CyberPit/FreeDSP_Classic_SMD_AB_plus-II/README.md

# FreeDSP_Classic_SMD_AB_plus-II

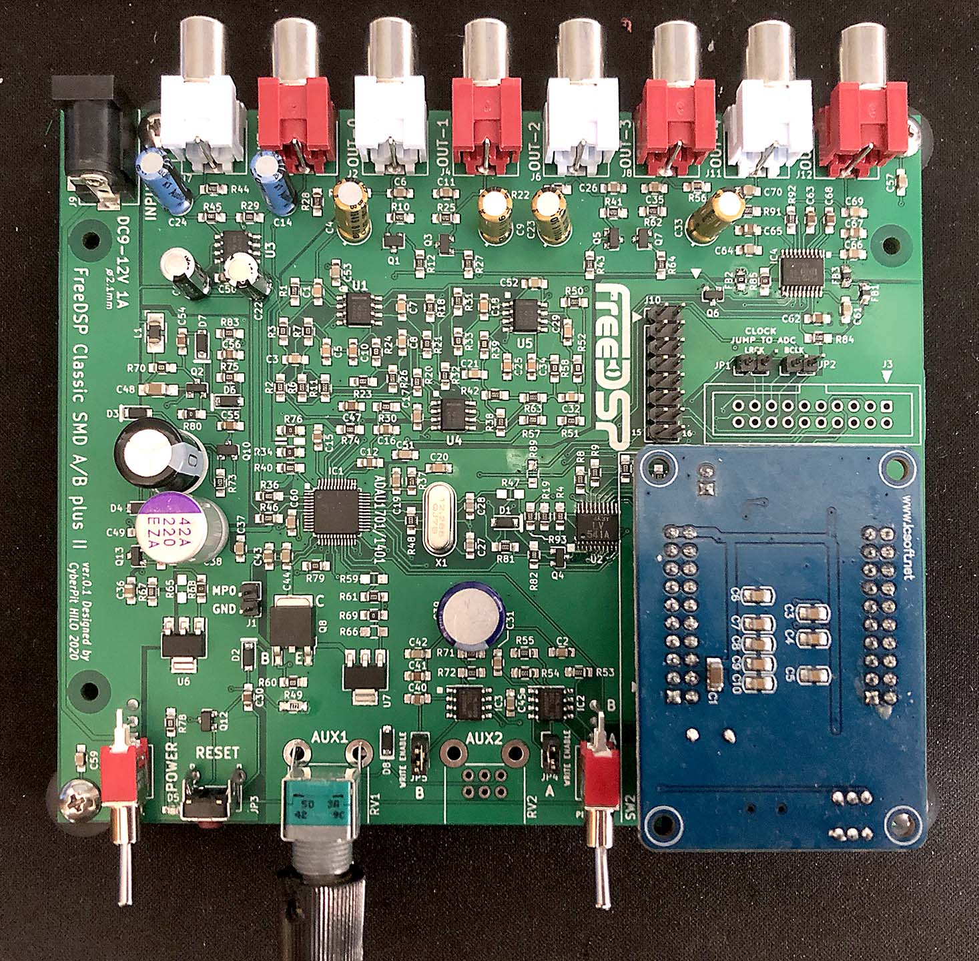
[picture p1: Photo/FDSPplus2Mounted.jpg]
Image of FreeDSP Classic SMD plus2


- 2in6out RCA jacks
- Integrated FreeUSBi
- A/B Selectable EEPROMs
- PCM5102A for DIG6/7
- ADAU1701 Board with selectable A/B Boot
- 0805(2.0mm x 1.25mm) SMD Resistors & Capacitors
- Through-Hole Ele-Caps
- Unity Gain Analog Audio I/O
- Absolute Phase transparent.
- Power ON/OFF/Reset Audio Pops Mute
- Buffered I2S I/O Headers (with Enable control feature)
- I6S Header pin for external DACs. 

Project web page: (Direct Link)
https://cyberpithilo.web.fc2.com/audio/freedsp/index.html

Project web page: (Yandex Machine Translation)
https://translate.yandex.com/translate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

Project web page: (Google Machine Translation)
https://translate.google.com/translate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

I had the ver0.1 board ordered to JLPCB (https://jlcpcb.com/) 
You can order SMT and Boards. My ordered PCBA file package is also included. 

# License
This work and all other materials under https://github.com/freeDSP are licensed under a Creative Commons Attribution Share-Alike 4.0 license. This allows for both personal and commercial derivative works, as long as they credit freeDSP and release their designs under the same license.
