CyberPit/FreeDSP_Classic_SMD_AB_plus-II/Photo/ChassisInsideTopiew.jpg

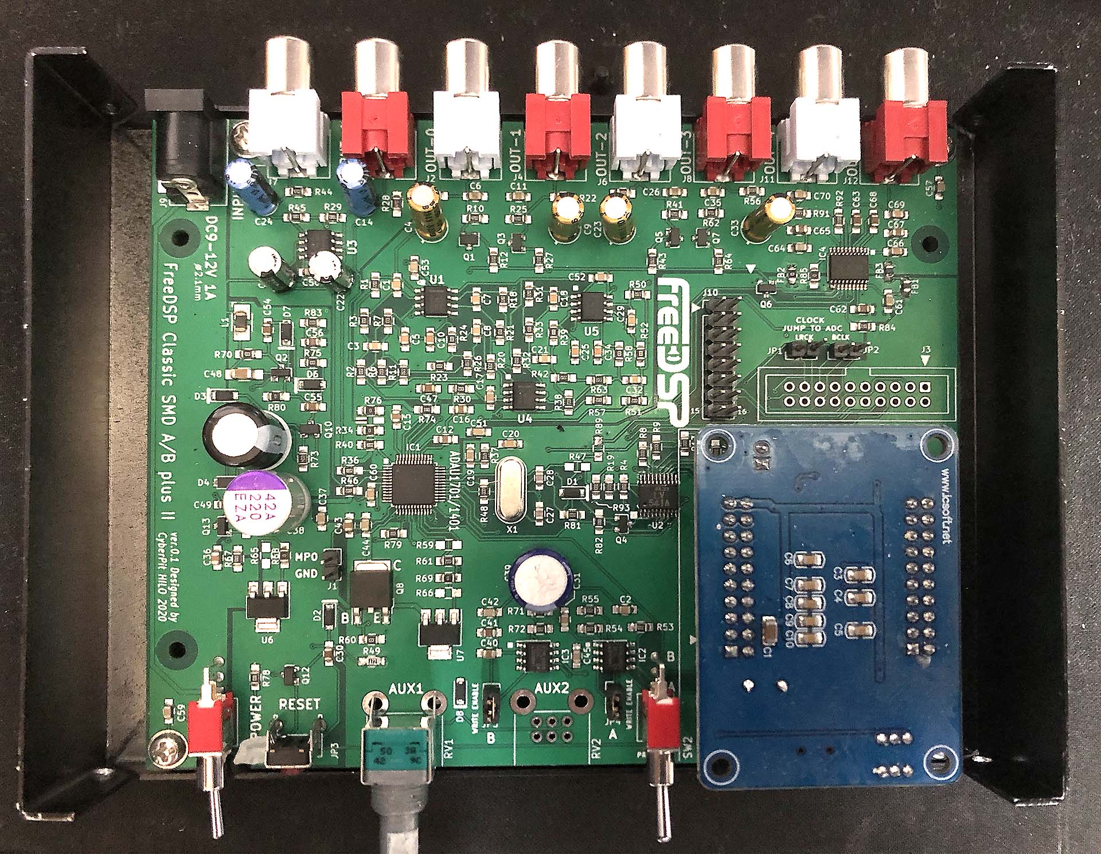
Photo/ChassisInsideTopiew.jpg
