CyberPit/FreeDSP_Classic_SMD_AB_plus-II/Photo/FreeDSP_SMD_AB_plus_TopView.jpg

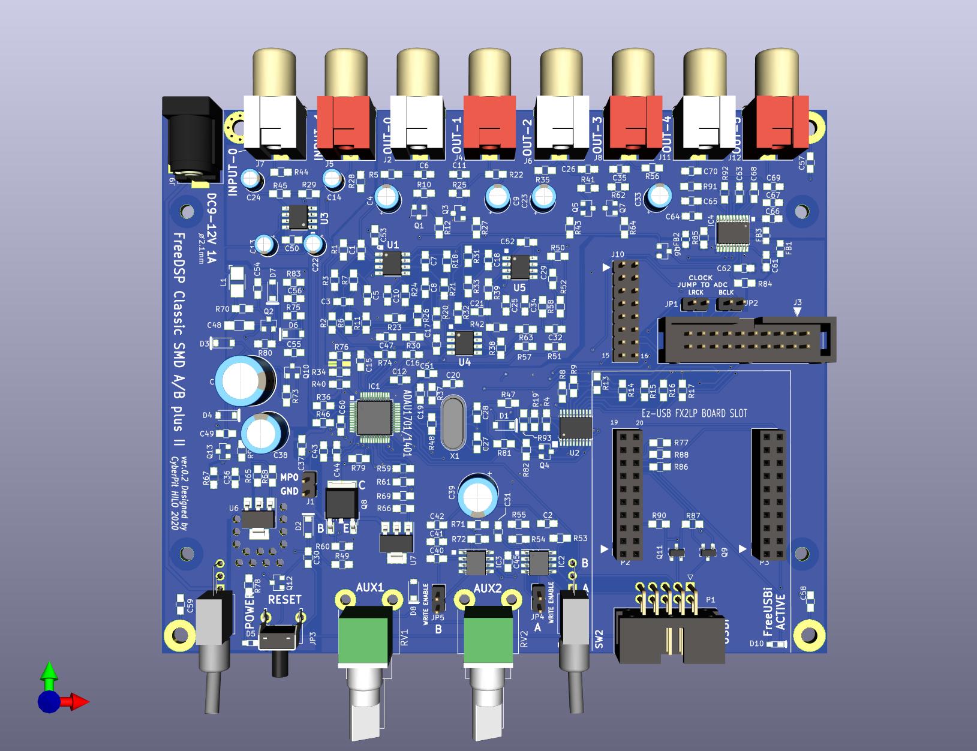
Photo/FreeDSP_SMD_AB_plus_TopView.jpg
