CyberPit/FreeDSP_Classic_SMD_AB_plus-II/Photo/FrontUp.jpg

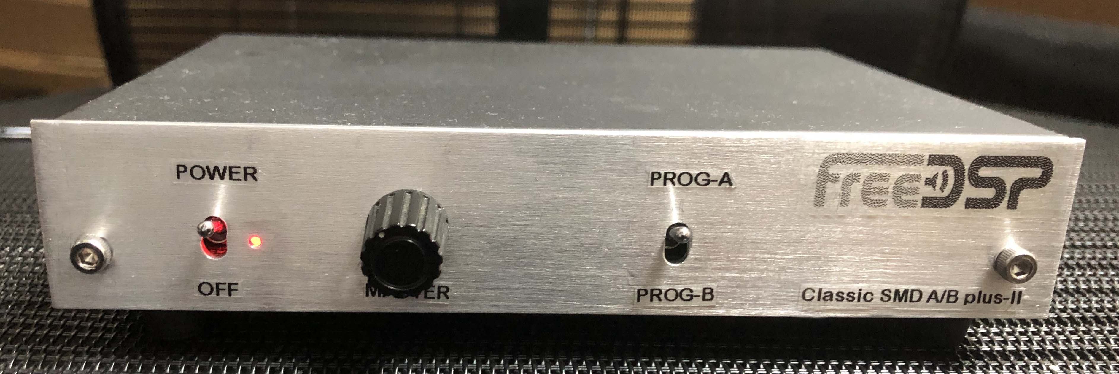
Photo/FrontUp.jpg
