CyberPit/FreeDSP_Classic_SMD_AB_plus-II/Photo/Measuring.jpg

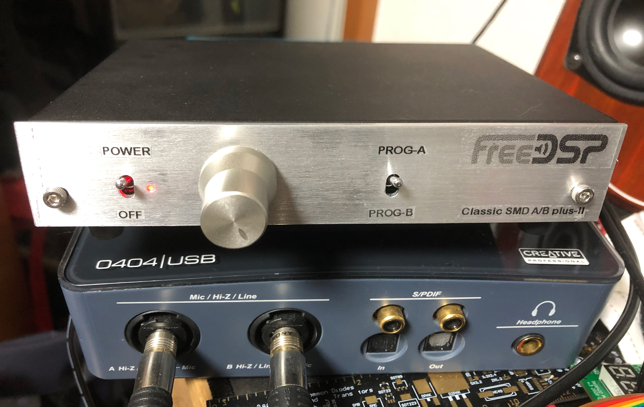
Photo/Measuring.jpg
