CyberPit/FreeDSP_Classic_SMD_AB_plus-II/Photo/NewFrontPanel.jpg

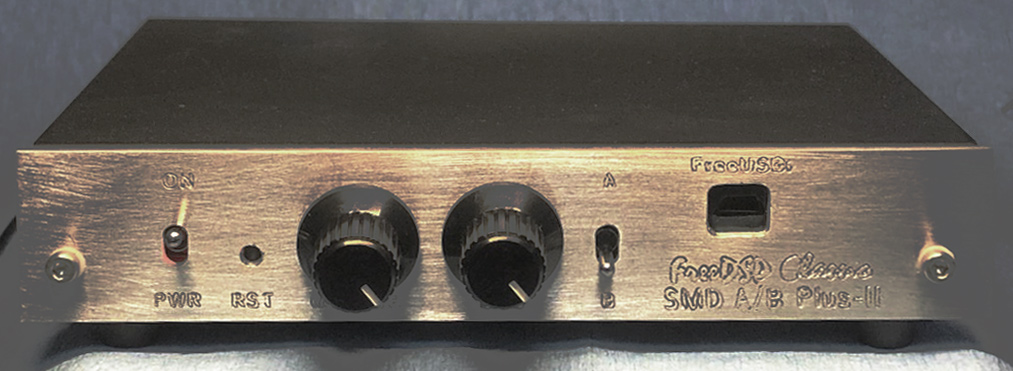
Photo/NewFrontPanel.jpg
