CyberPit/FreeDSP_Classic_SMD_AB_plus-II/Photo/PCBA@JLPCB.jpg

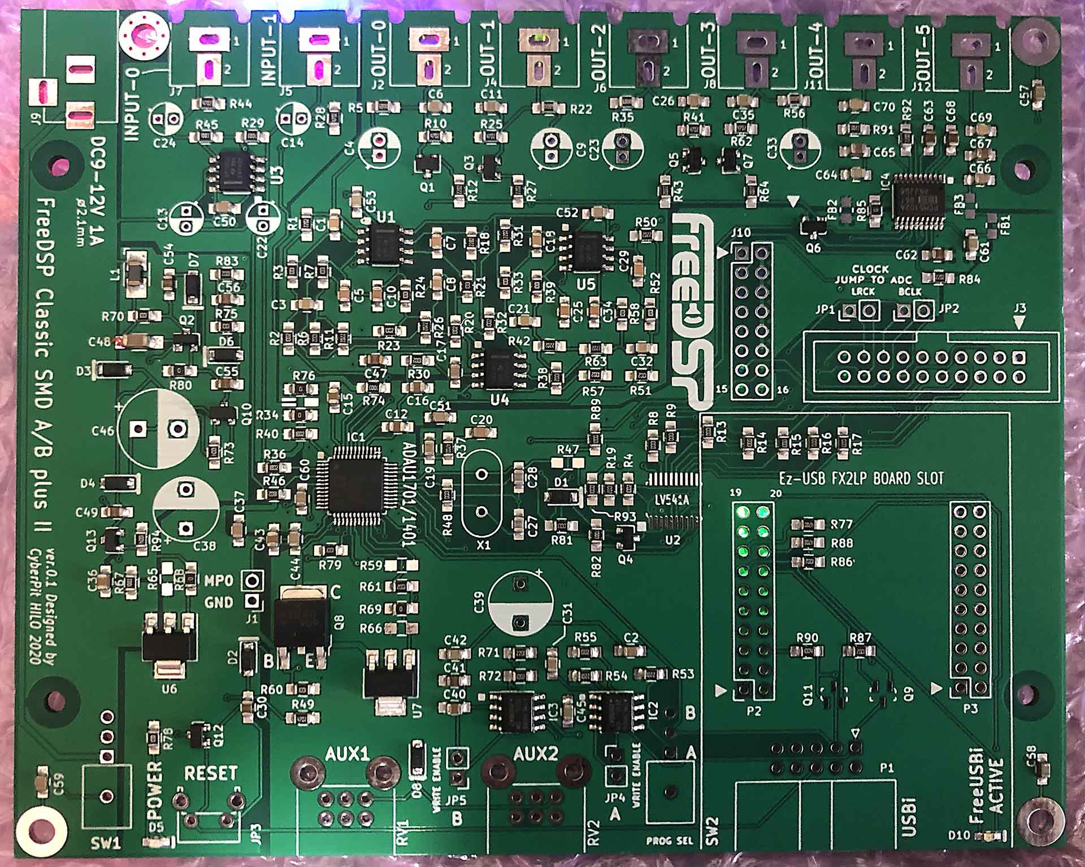
Photo/PCBA@JLPCB.jpg
