CyberPit/FreeDSP_Classic_SMD_AB_plus-II/Photo/PCBA_Bottom.jpg

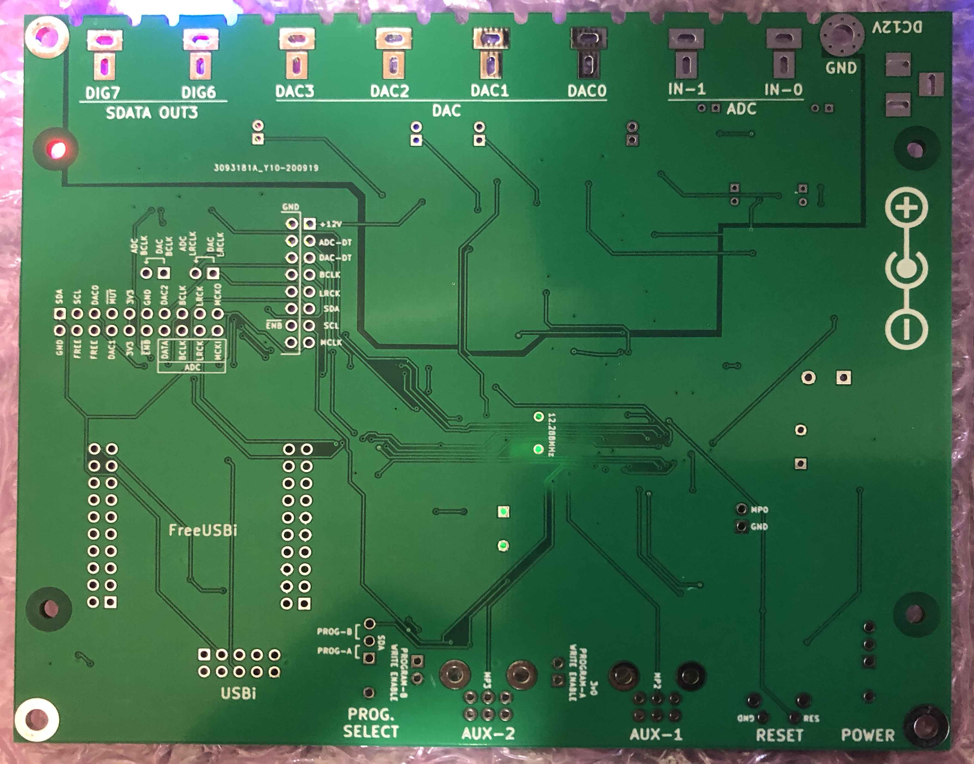
Photo/PCBA_Bottom.jpg
