CyberPit/FreeDSP_Classic_SMD_AB_plus-II/Photo/RerPanel.jpg

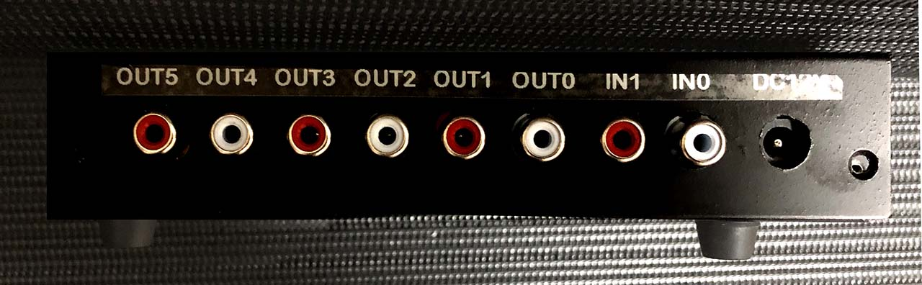
Photo/RerPanel.jpg
