CyberPit/FreeDSP_Classic_SMD_AB_plus-II/Photo/SigmaStudio96kHz_3way_CD_Example.GIF

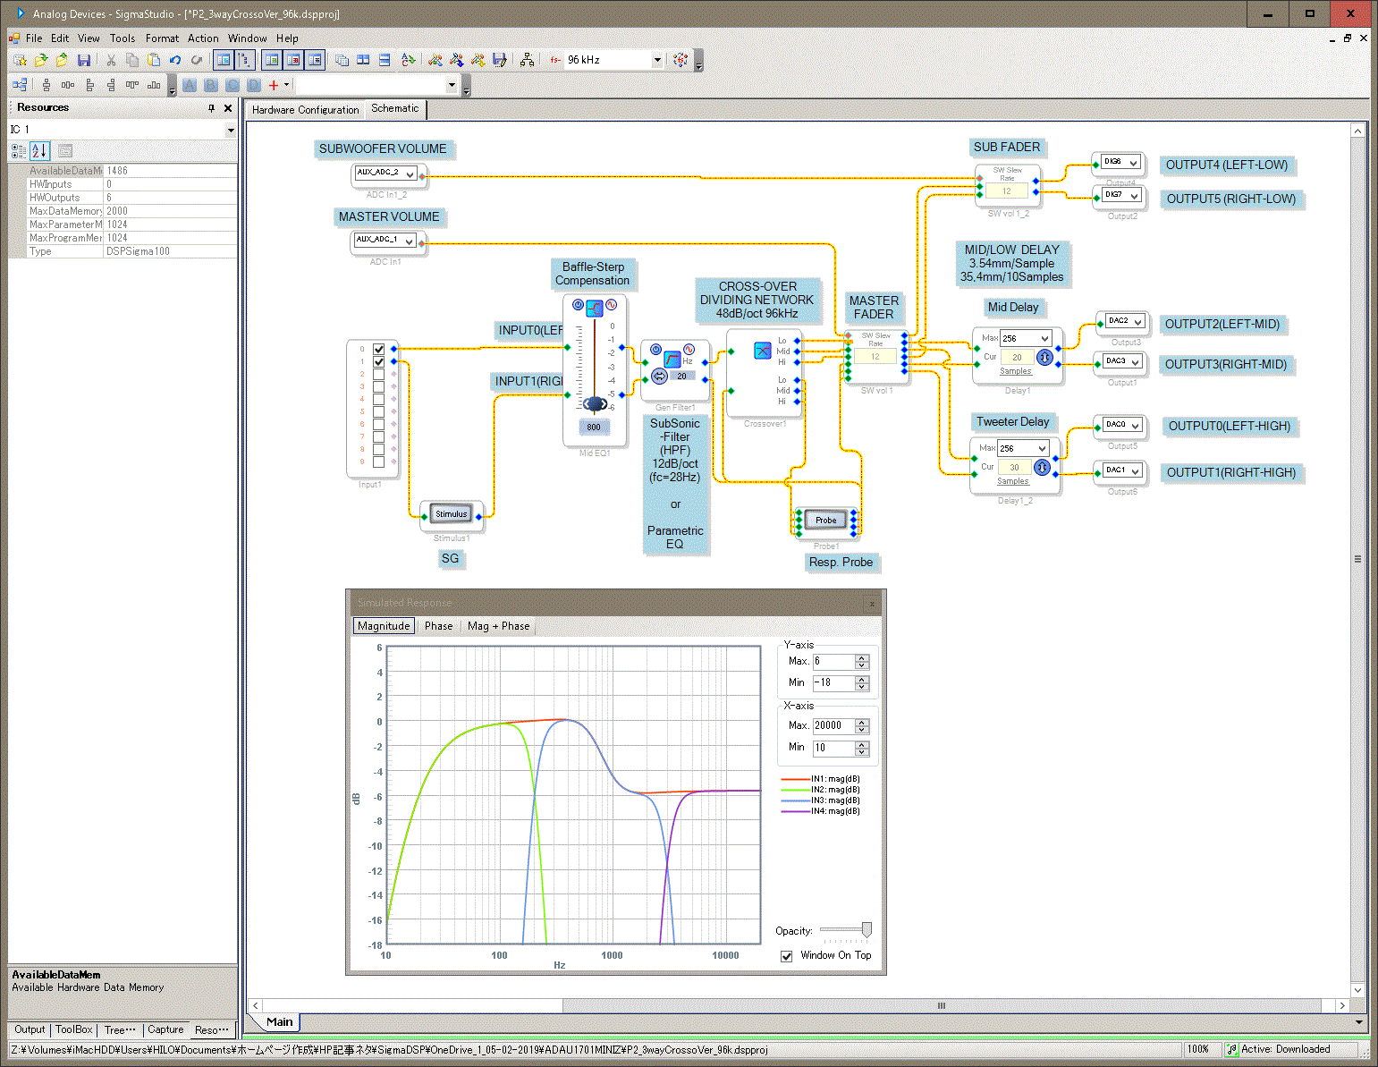
Photo/SigmaStudio96kHz_3way_CD_Example.GIF
