CyberPit/FreeDSP_Classic_SMD_AB_plus-II/Photo/SubPanel.jpg

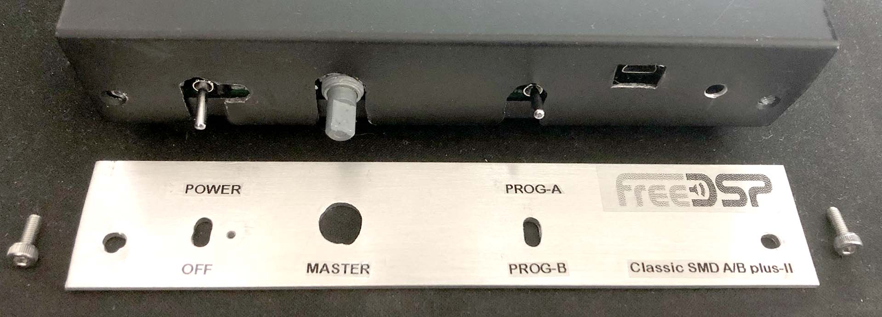
Photo/SubPanel.jpg
