CyberPit/FreeDSP_Classic_SMD_AB_plus-II/Photo/UpFront2.jpg

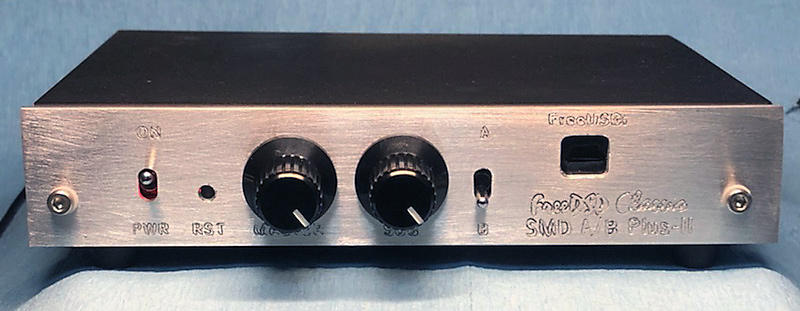
Photo/UpFront2.jpg
