CyberPit/FreeDSP_Classic_SMD_AB_plus-II/Photo/Working.jpg

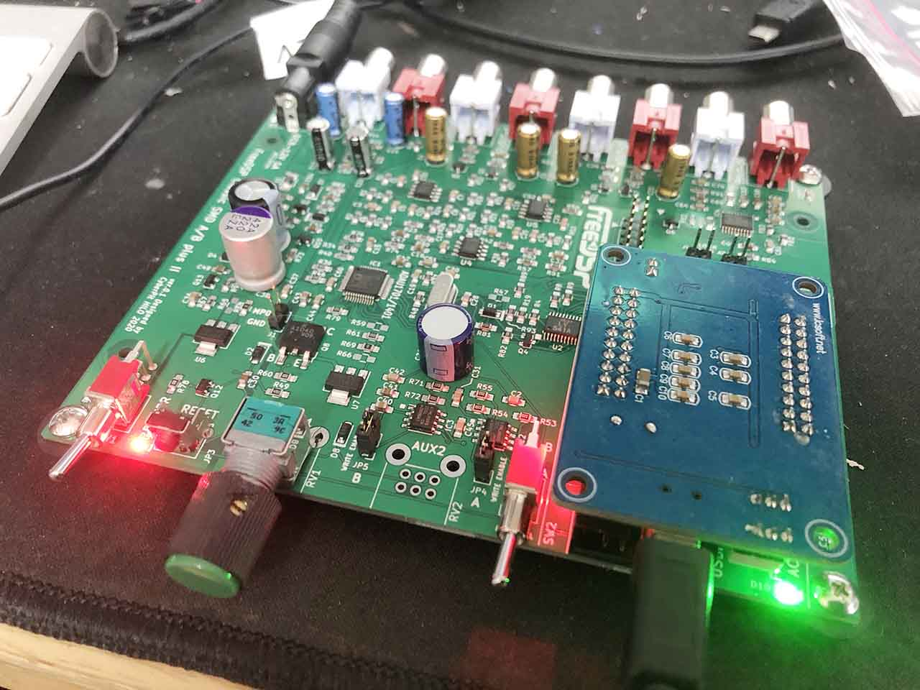
Photo/Working.jpg
