CyberPit/FreeDSP_Classic_SMD_AB_plus-II/RMAA HTML/Comparison/ct.png

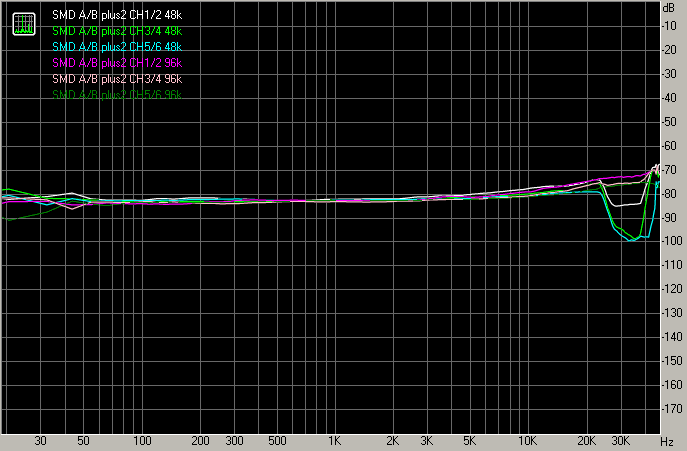
RMAA HTML/Comparison/ct.png
