CyberPit/FreeDSP_Classic_SMD_AB_plus-II/RMAA HTML/Comparison/dr.png

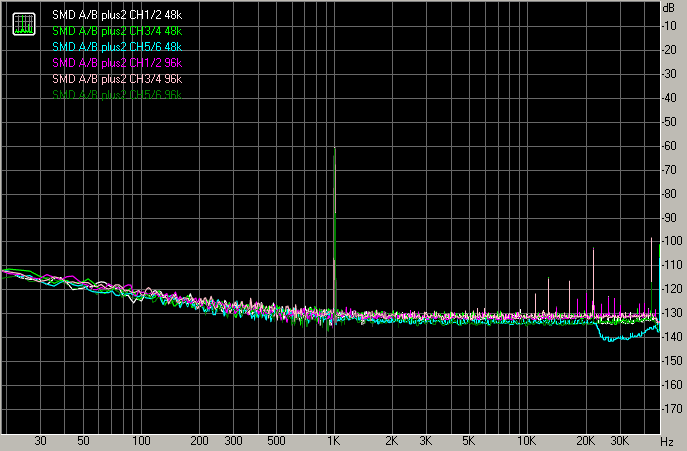
RMAA HTML/Comparison/dr.png
