CyberPit/FreeDSP_Classic_SMD_AB_plus-II/RMAA HTML/Comparison/thd.png

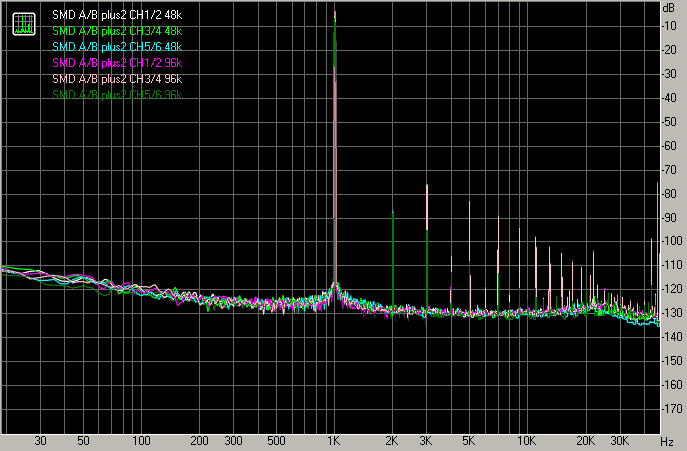
RMAA HTML/Comparison/thd.png
