CyberPit/FreeDSP_Classic_SMD_AB_plus-II/RMAA HTML/SMD A_B plus2 CH1_2 48k/cross.png

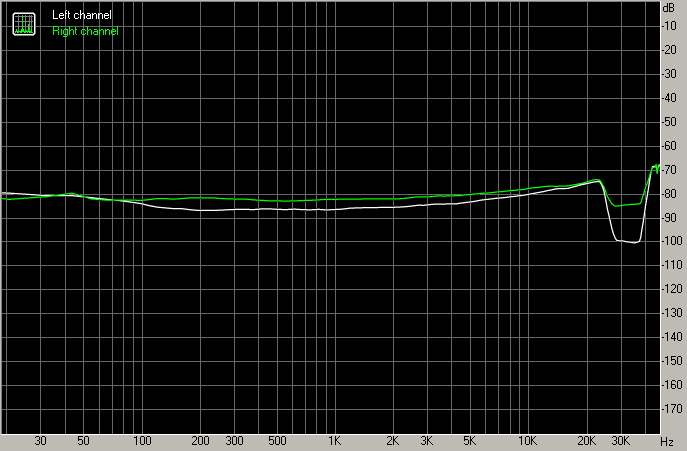
RMAA HTML/SMD A_B plus2 CH1_2 48k/cross.png
