CyberPit/FreeDSP_Classic_SMD_AB_plus-II/RMAA HTML/SMD A_B plus2 CH1_2 96k/imd-20.png

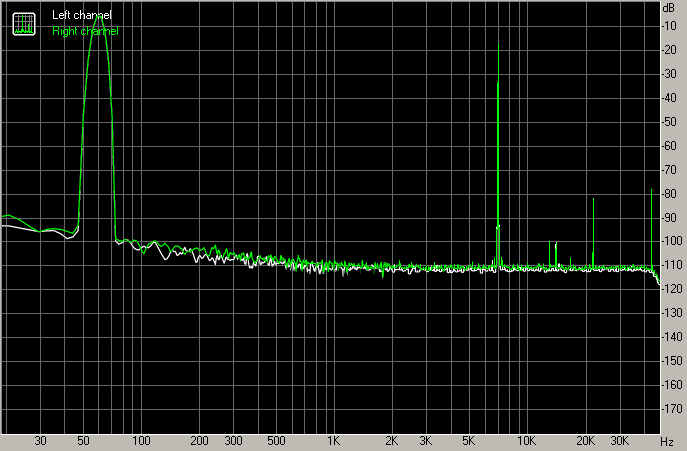
RMAA HTML/SMD A_B plus2 CH1_2 96k/imd-20.png
