CyberPit/FreeDSP_Classic_SMD_AB_plus-II/Doc/FreeDSP_SMD_AB_plus2_ExcludeParts-PCBA.pdf

Designator | Package | Quantity | Designation | @ | Cost | Supplier and ref | Comment
C13,C22 | CP_Radial_D4.0mm_P2.00mm | 2 | 47uF/6.3 | 20 | 40 | http://akizukidenshi.com/catalog/g/gP-05186/
C14,C24 | CP_Radial_D4.0mm_P2.00mm | 2 | 4.7uF/16 | 20 | 40 | http://akizukidenshi.com/catalog/g/gP-06887/
C38,C39 | CP_Radial_D8.0mm_P5.00mm | 2 | 220u/6.3 | 50 | 100 | http://akizukidenshi.com/catalog/g/gP-08291/
C4,C9,C23,C33 | CP_Radial_D5.0mm_P2.00mm | 4 | 10u | 10 | 40 | http://akizukidenshi.com/catalog/g/gP-04621/
C46 | CP_Radial_D10.0mm_P5.00mm | 1 | 220u/16V | 50 | 50 | http://akizukidenshi.com/catalog/g/gP-08291/
J1,JP4,JP5,JP1,JP2 | PinHeader_1x02_P2.54mm_Vertical | 5 | Conn_01x02 | 2.5 | 12.5 | http://akizukidenshi.com/catalog/g/gC-08593/
J10 | Pin_Header_Straight_2x08_Pitch2.54mm | 1 | Conn_02x08_Odd_Even | 50 | 50 | http://akizukidenshi.com/catalog/g/gC-00082/
J4,J5,J8,J12 | RJ-2410N/R | 4 | Conn_Coaxial | 40 | 160 | https://akizukidenshi.com/catalog/g/gC-02385/ | ⾚⾊
J2,J6,J11 | RJ-2410N/W | 3 | Conn_Coaxial | 40 | 120 | https://akizukidenshi.com/catalog/g/gC-02386/ | ⽩⾊
J7 | RJ-2410N/B | 1 | Conn_Coaxial | 50 | 50 | https://akizukidenshi.com/catalog/g/gC-06509/ | ⿊⾊ (⽩でも可）
J3 | IDC-Header_2x10_P2.54mm_Vertical | 1 | Conn_02x10_Odd_Even | 40 | 40 | http://akizukidenshi.com/catalog/g/gC-13176/
J9 | BARREL_JACK | 1 | Conn_Coaxial_Power | 40 | 40 | http://akizukidenshi.com/catalog/g/gC-06568/
JP3 | SW_Tactile_SPST_Angled_PTS645Vx83-2LFS | 1 | TACT_ANGLE_PUSH | 10 | 10 | http://akizukidenshi.com/catalog/g/gP-07193/
P1 | IDC-Header_2x05_P2.54mm_Horizontal | 1 | USBi | 25 | 25 | http://akizukidenshi.com/catalog/g/gC-13178/
P2,P3 | PinSocket_2x10_P2.54mm_Vertical | 2 | CONN_02X10 | 50 | 100 | http://akizukidenshi.com/catalog/g/gC-00083/
RV1,RV2 | Potentiometer_Alps_RK09L_Double_Vertical | 2 | R_POT_ALPS_RK09_B10K | 125 | 250 | http://akizukidenshi.com/catalog/g/gP-12576/ | Bカーブであれば可
SW1,SW2 | 2MS1T1B4M7QES (SPDT Switch) | 2 | 2MS1T1B4M7QES | 110 | 220 | http://akizukidenshi.com/catalog/g/gP-13796/
X1 | Crystal_HC49-U_Vertical | 1 | 12.288MHz | 166 | 166 | https://www.sengoku.co.jp/mod/sgk_cart/detail.php?code=6ATP-C3DC
U2 | TSSOP-20_W4.4mm | 1 | 74LV541A | 20 | 20 | http://akizukidenshi.com/catalog/g/gI-03440/ | 0.65mm pitch TSSOP-20pin
FB1,FB2,FB3 | Bead 0805 | 3 | BLM21PG331SN1D or GZ2012D601TF | 4 | 12 | http://akizukidenshi.com/catalog/g/gP-04053/ | 2.0x1.25mm Beads
Q9,Q11 | SOT-23-3 | 2 | AO3400A | 22 | 44 | https://akizukidenshi.com/catalog/g/gI-14653/ | 2N7002でも可
Accesary | Jumper-pin Set Pitch2.54mm | 1 | LRCLK_BRIDGE | 100 | 100 | http://akizukidenshi.com/catalog/g/gP-03687/ | 書き込み時JP4,JP5に必要
| | | 合計 | | 1690
C1,C5,C7,C10,C25,C29,C34,C18 | C_0805_HandSoldering | 8 | ECHU 150pF | 36 | 288 | https://www.sengoku.co.jp/mod/sgk_cart/detail.php?code=EEHD-58F5 | ⾳質対策品（任意換装）
C3,C8,C32,C21,C69,C70 | C_0805_HandSoldering | 6 | ECHU 1000pF | 36 | 216 | https://www.sengoku.co.jp/mod/sgk_cart/detail.php?code=3BK5-TEDR | ⾳質対策品（任意換装）
| | | 合計 | | 504
U2 | TSSOP-20 | 1 | HD74LV541A | 20 | 20 | https://akizukidenshi.com/catalog/g/gI-03440/ | I2S拡張機能が必要な⽅のみ
J3 | 20 Pin Header with SH P=2.54mm | 1 | ボックスヘッダ20P(10x2列） | 45 | 45 | https://akizukidenshi.com/catalog/g/gC-13176/ | I2S拡張機能が必要な⽅のみ
JP1, JP2 | 2 Pin Header P=2.54mm | 2 | ピンヘッダ2P | 10 | 20 | https://akizukidenshi.com/catalog/g/gC-08593/ | 外部ADCを使⽤する場合のみ必要
