CyberPit/FreeDSP_Classic_SMD_AB_plus-II/PCBA-Order_Files_for_JLPCB/FreeDSP_SMD_AB_plus_0v2_BOM1.xlsx

Comment | Designator | Footprint | JLCPCB Part #（optional）
150p | C1,C5,C7,C10,C25,C29,C34,C18 | C_0805 | C1716
10u | C12,C36,C40,C43,C15,C16,C65,C67 | C_0805 | C15850
100n | C2,C31,C37,C42,C44,C45,C17,C50,C51,C52,C53,C57,C58,C59,C60,C61,C64,C66 | C_0805 | C49678
56n | C20 | C_0805 | C1756
33p | C27,C28 | C_0805 | C1814
1000PF | C3,C8,C32,C21,C69,C70 | C_0805 | C46653
2.2u | C30,C41,C47,C49,C54,C55,C56,C62,C63,C68 | C_0805 | C49217
10uF | C48 | C_1206_HandSoldering | C13585
3n3 | C6,C11,C26,C35,C19 | C_0805 | C53175
LED_GRN | D10 | LED_0603_HandSoldering | C72043
1N4148W | D3,D1,D2 | D_SOD-123 | C81598
LED_RED | D5 | LED_0603_HandSoldering | C2286
B5819W | D6,D7,D4,D8 | D_SOD-123 | C8598
GZ2012D601TF | FB1,FB2,FB3 | 0805 | C1017
ADAU1701 | IC1 | LQFP-48_7x7mm_Pitch0.5mm | C389590
24AA256 | IC3,IC2 | SOIC-8_3.9x4.9mm_Pitch1.27mm | C6482
PCM5102APWR | IC4 | TSSOP-20_4.4x6.5mm_P0.65mm | C107671
CMI321609X100KT | L1 | Inductor_1206 | C1051
2SC3326 | Q1,Q3,Q7,Q5 | SOT-23 | C27829
AO3401A | Q10,Q12 | SOT-23-3L | C15127
2N7002 | Q2,Q4,Q6,Q13,Q9,Q11 | SOT-23-3 | C8545
KTA1040D-Y-RTF/P | Q8 | TO-252-2 | C69791
22k | R1,R11,R12,R18,R26,R27,R31,R42,R43,R50,R63,R64,R84 | R_0805 | C17560
47k | R10,R25,R28,R41,R44,R62 | R_0805 | C17713
4.7k | R49 | R_0805 | C23162
10k | R2,R6,R19,R20,R23,R30,R32,R38,R51,R55,R57,R61,R72,R4,R83,R86,R87 | R_0805 | C17414
100k | R29,R45,R67 | R_0805 | C17407
0R | R34,R68,R69,R76,R80,R85 | R_0805 | C17477
18k | R36,R40,R46 | R_0805 | C17506
470R | R37,R77,R88 | R_0805 | C17710
680R | R5,R22,R35,R56 | R_0805 | C17798
2k2 | R53,R54,R71 | R_0805 | C17520
1k | R70,R3,R7,R21,R24,R33,R39,R52,R58,R60,R75,R78,R79 | R_0805 | C17513
1MEG | R73,R90,R94 | R_0805 | C17514
100K | R74,R82 | R_0805 | C17407
100R | R8,R9,R13,R14,R15,R16,R17,R48,R81,R93 | R_0805 | C17408
220R | R91,R92 | R_0805 | C17557
OPA1652 | U1,U3,U4,U5 | SOIC127P600X175-8N | C30025
SN74LV541APWR | U2 | TSSOP-20_4.4x6.5x0.65P | C406870
AMS1117-5.0 | U6 | SOT-223 | C6187
AMS1117-3.3 | U7 | SOT-223 | C6186
