CyberPit/FreeDSP_Classic_SMD_AB_plus-II/(threads)

Thread 2 (2023-07-13):

JLCPCB Files are corrupted

DevFelixLiS, 2023-07-13:
When uploading `FreeDSP_SMD_AB_plus_0v2_BOM1` and `FreeDSP_SMD_AB_plus_0v2-CPL1`, i'm getting to the next page. Unfortunattly, the parts of the PCB are misplaced. When trying `FreeDSP_SMD_AB_plus_BOM1` and `FreeDSP_SMD_AB_plus-top-CPL1`, JLCPCB is throwing the following Error: `File processing failed, please check your file and upload again.`

CyberPit, 2023-07-13:
Thanks for notifying the errors.
The offset-adjusted Gerber file was uploaded.

CyberPit

Closed 2023-07-13.

Thread 4 (2024-06-23):

Kikad 3D Footprint Libary for components

azzajess, 2024-06-23:
Hey there, im wondering if you can supply the 3D component kikad footprint library's for some of the components on the classic smb, specifically the RCAs, POT, and rocker switch? The image below is from your website showing a 3D view of it.
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

Im trying to create a 3D printed enclosure and believe this will make it a bit easier to get dimensions correctly.
Thanks
