CyberPit/FreeDSP_Classic_SMD_AB_plus-II/Doc/FreeDSP_SMD_AB_plus2_Schematic.pdf

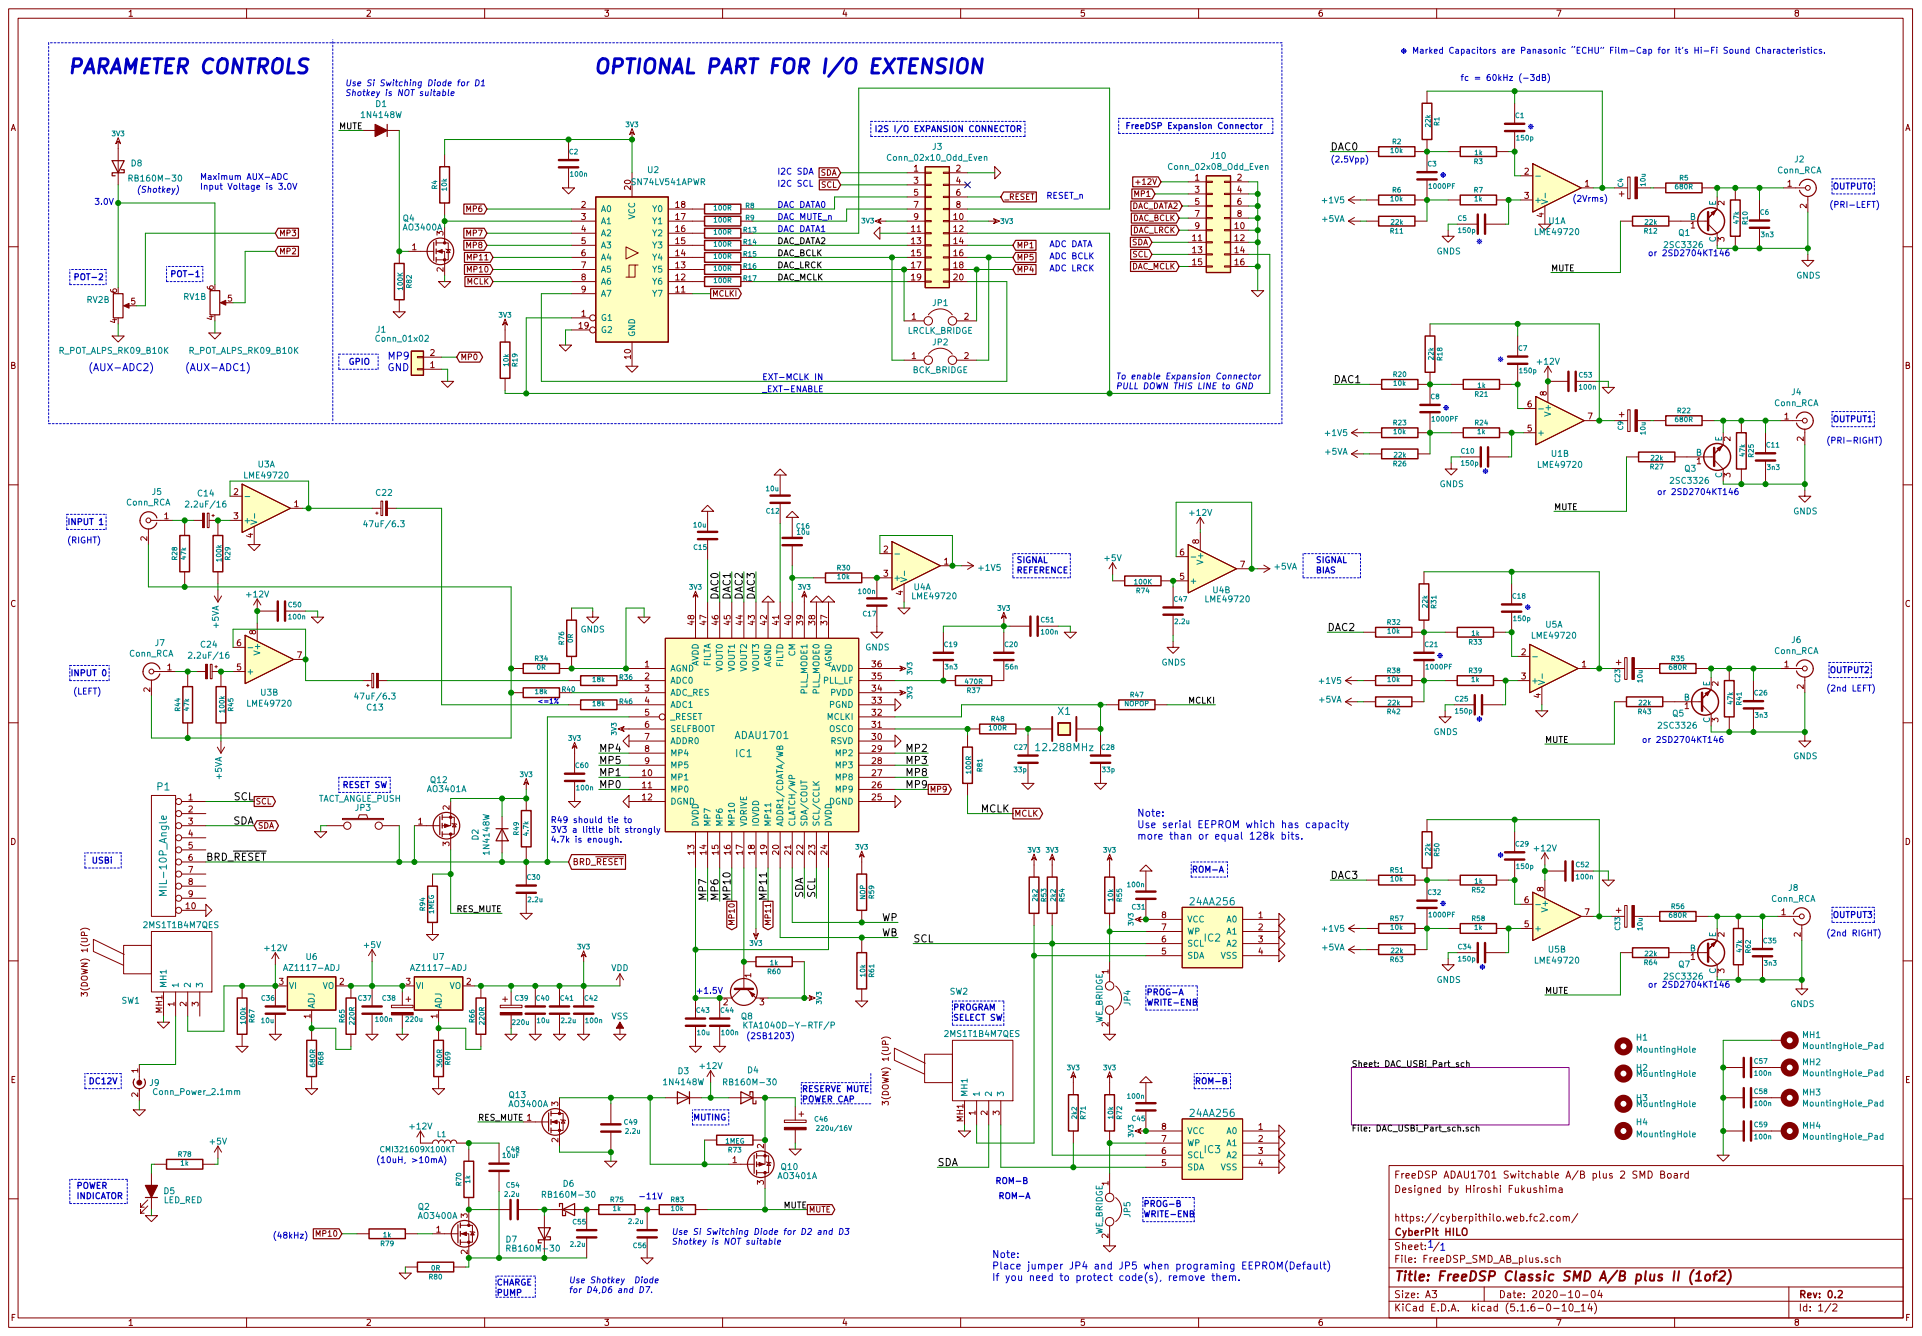
[picture p26: page 1]

Marked Capacitors are Panasonic ECHU Film-Cap for its Hi-Fi Sound Characteristics.

OPTIONAL PART FOR I/O EXTENSION

_EXT-ENABLE Use Si Switching Diode for D1
Shotkey is NOT suitable

SIGNAL REFERENCE Maximum AUX-ADC
Input Voltage is 3.0V

R49 should tie to 3V3 a little bit strongly

FreeDSP ADAU1701 Switchable A/B plus 2 SMD Board Sheet: DAC_USBi_Part_sch File: DAC_USBi_Part_sch.sch

Designed by Hiroshi Fukushima

https://cyberpithilo.web.fc2.com/
File: FreeDSP_SMD_AB_plus.sch Sheet: / CyberPit HILO
Id: 1/2 Title: FreeDSP Classic SMD A/B plus II (1of2)

Use Si Switching Diode for D2 and D3

Note: Place jumper JP4 and JP5 when programing EEPROM(Default)

If you need to protect code(s), remove them.

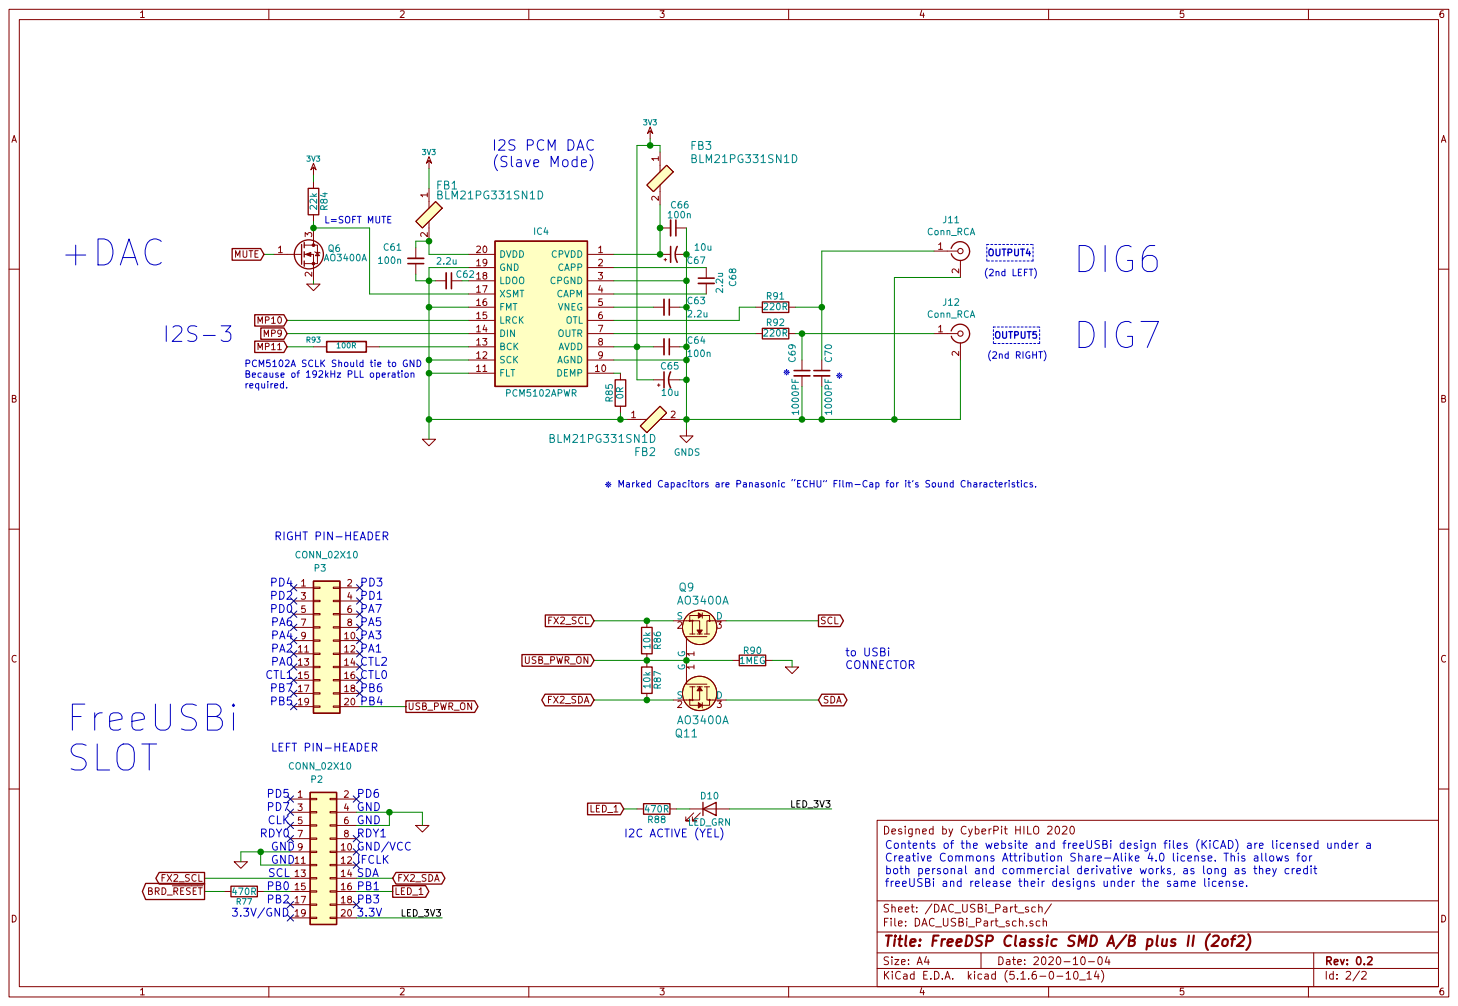
[picture p27: page 2]

PCM5102A SCLK Should tie to GND
Because of 192kHz PLL operation
required.

Marked Capacitors are Panasonic ECHU Film-Cap for its Sound Characteristics.

freeUSBi and release their designs under the same license. LEFT PIN-HEADER
9 P2 CONN_02X10
CLK RDY0 SCL PB2

Designed by CyberPit HILO 2020
Contents of the website and freeUSBi design files (KiCAD) are licensed under a
Creative Commons Attribution Share-Alike 4.0 license. This allows for
both personal and commercial derivative works, as long as they credit

Sheet: /DAC_USBi_Part_sch/
File: DAC_USBi_Part_sch.sch
Id: 2/2 Title: FreeDSP Classic SMD A/B plus II (2of2)
