CyberPit/FreeDSP_Classic_SMD_AB_plus-II/Doc/FreeDSP_SMD_AB_plus2_Diemensions.pdf

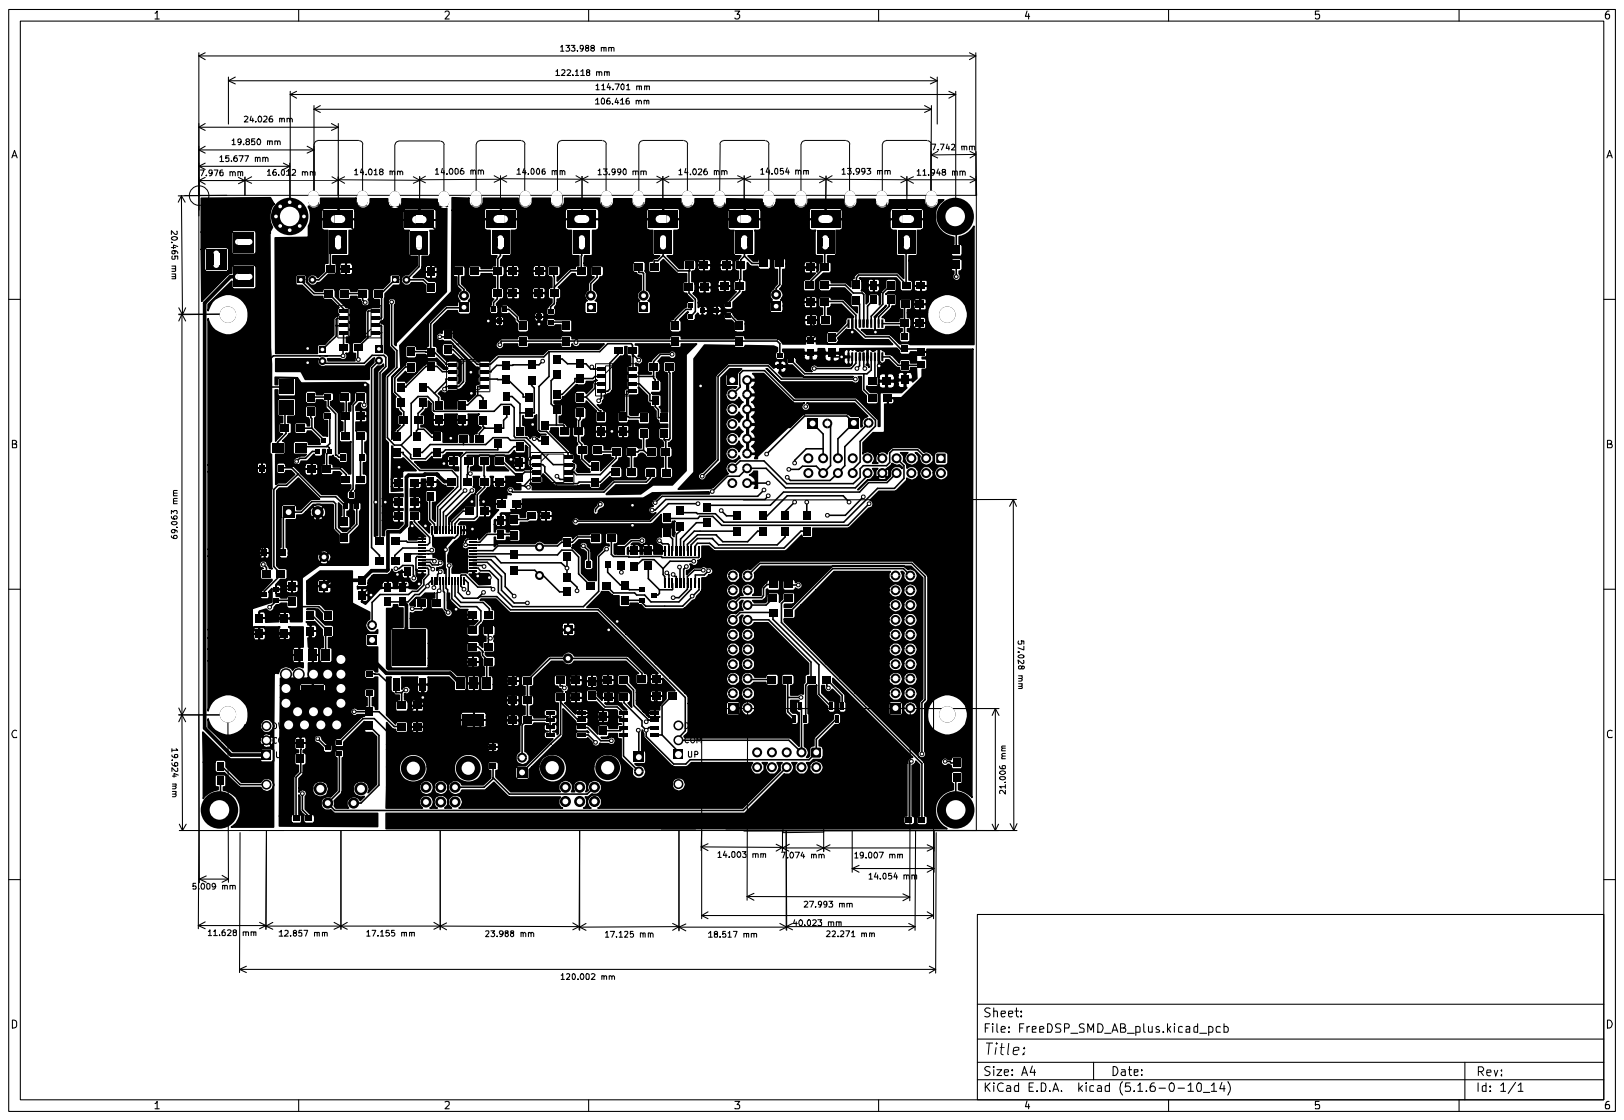
[picture p28: page 1]
