CyberPit/FreeDSP_Classic_SMD_AB_plus-II/(list of files, drawings)

Other design files:
KICAD/FreeDSP_SMD_AB_plus.dsn
