CyberPit/FreeDSP_Classic_SMD_AB_plus-II/KICAD/FreeDSP_SMD_AB_plus.kicad_pcb

## KiCad design KICAD/FreeDSP_SMD_AB_plus.kicad_pcb (2020-10-11)

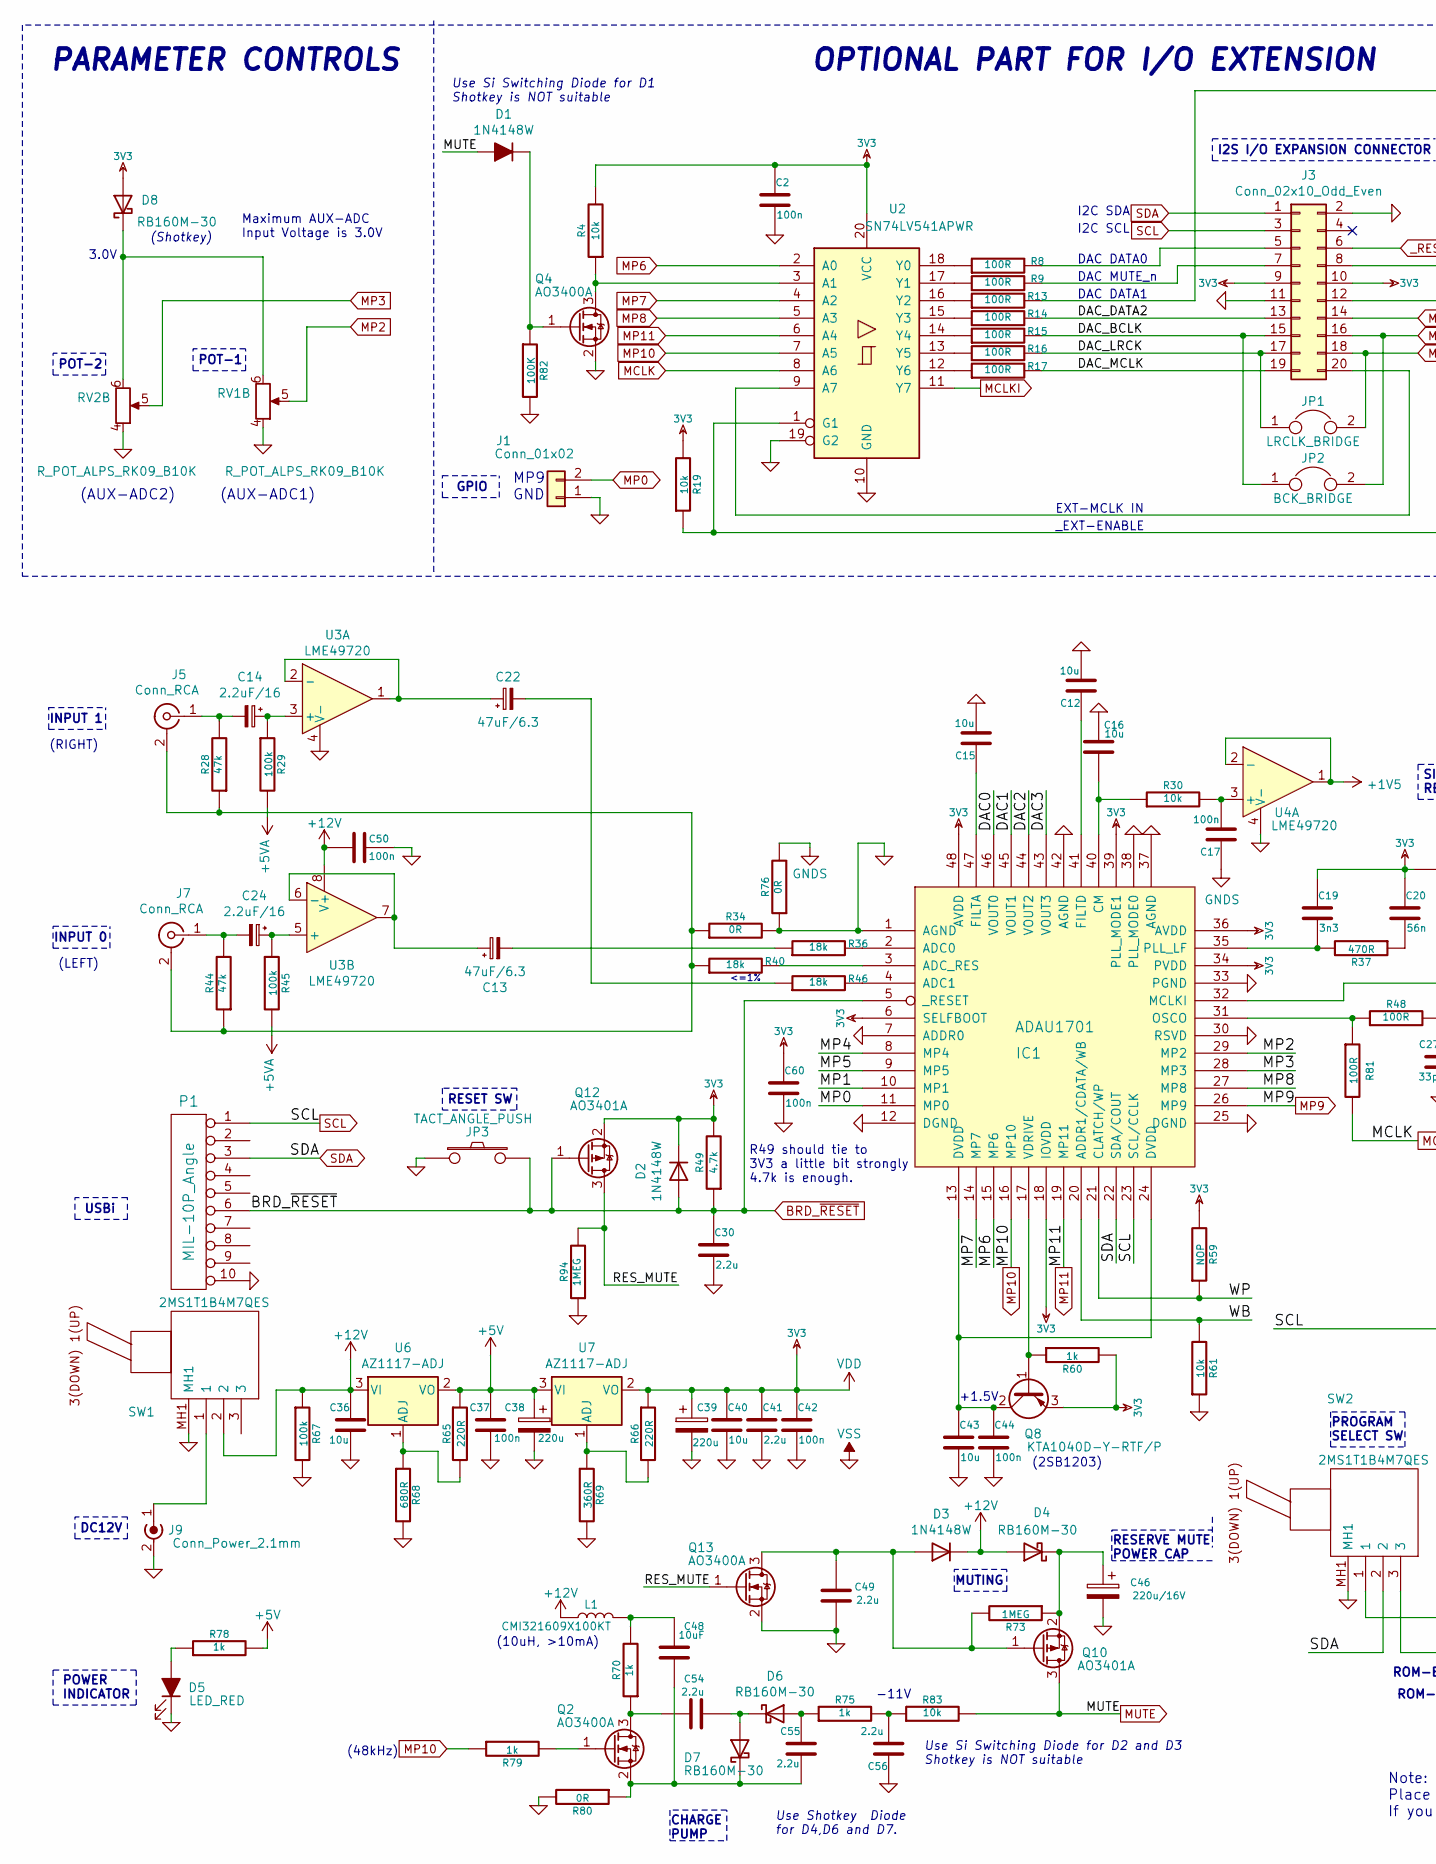
[picture p29: schematic FreeDSP_SMD_AB_plus.sch, FreeDSP Classic SMD A/B plus II (1of2), part in row 1, column 1]

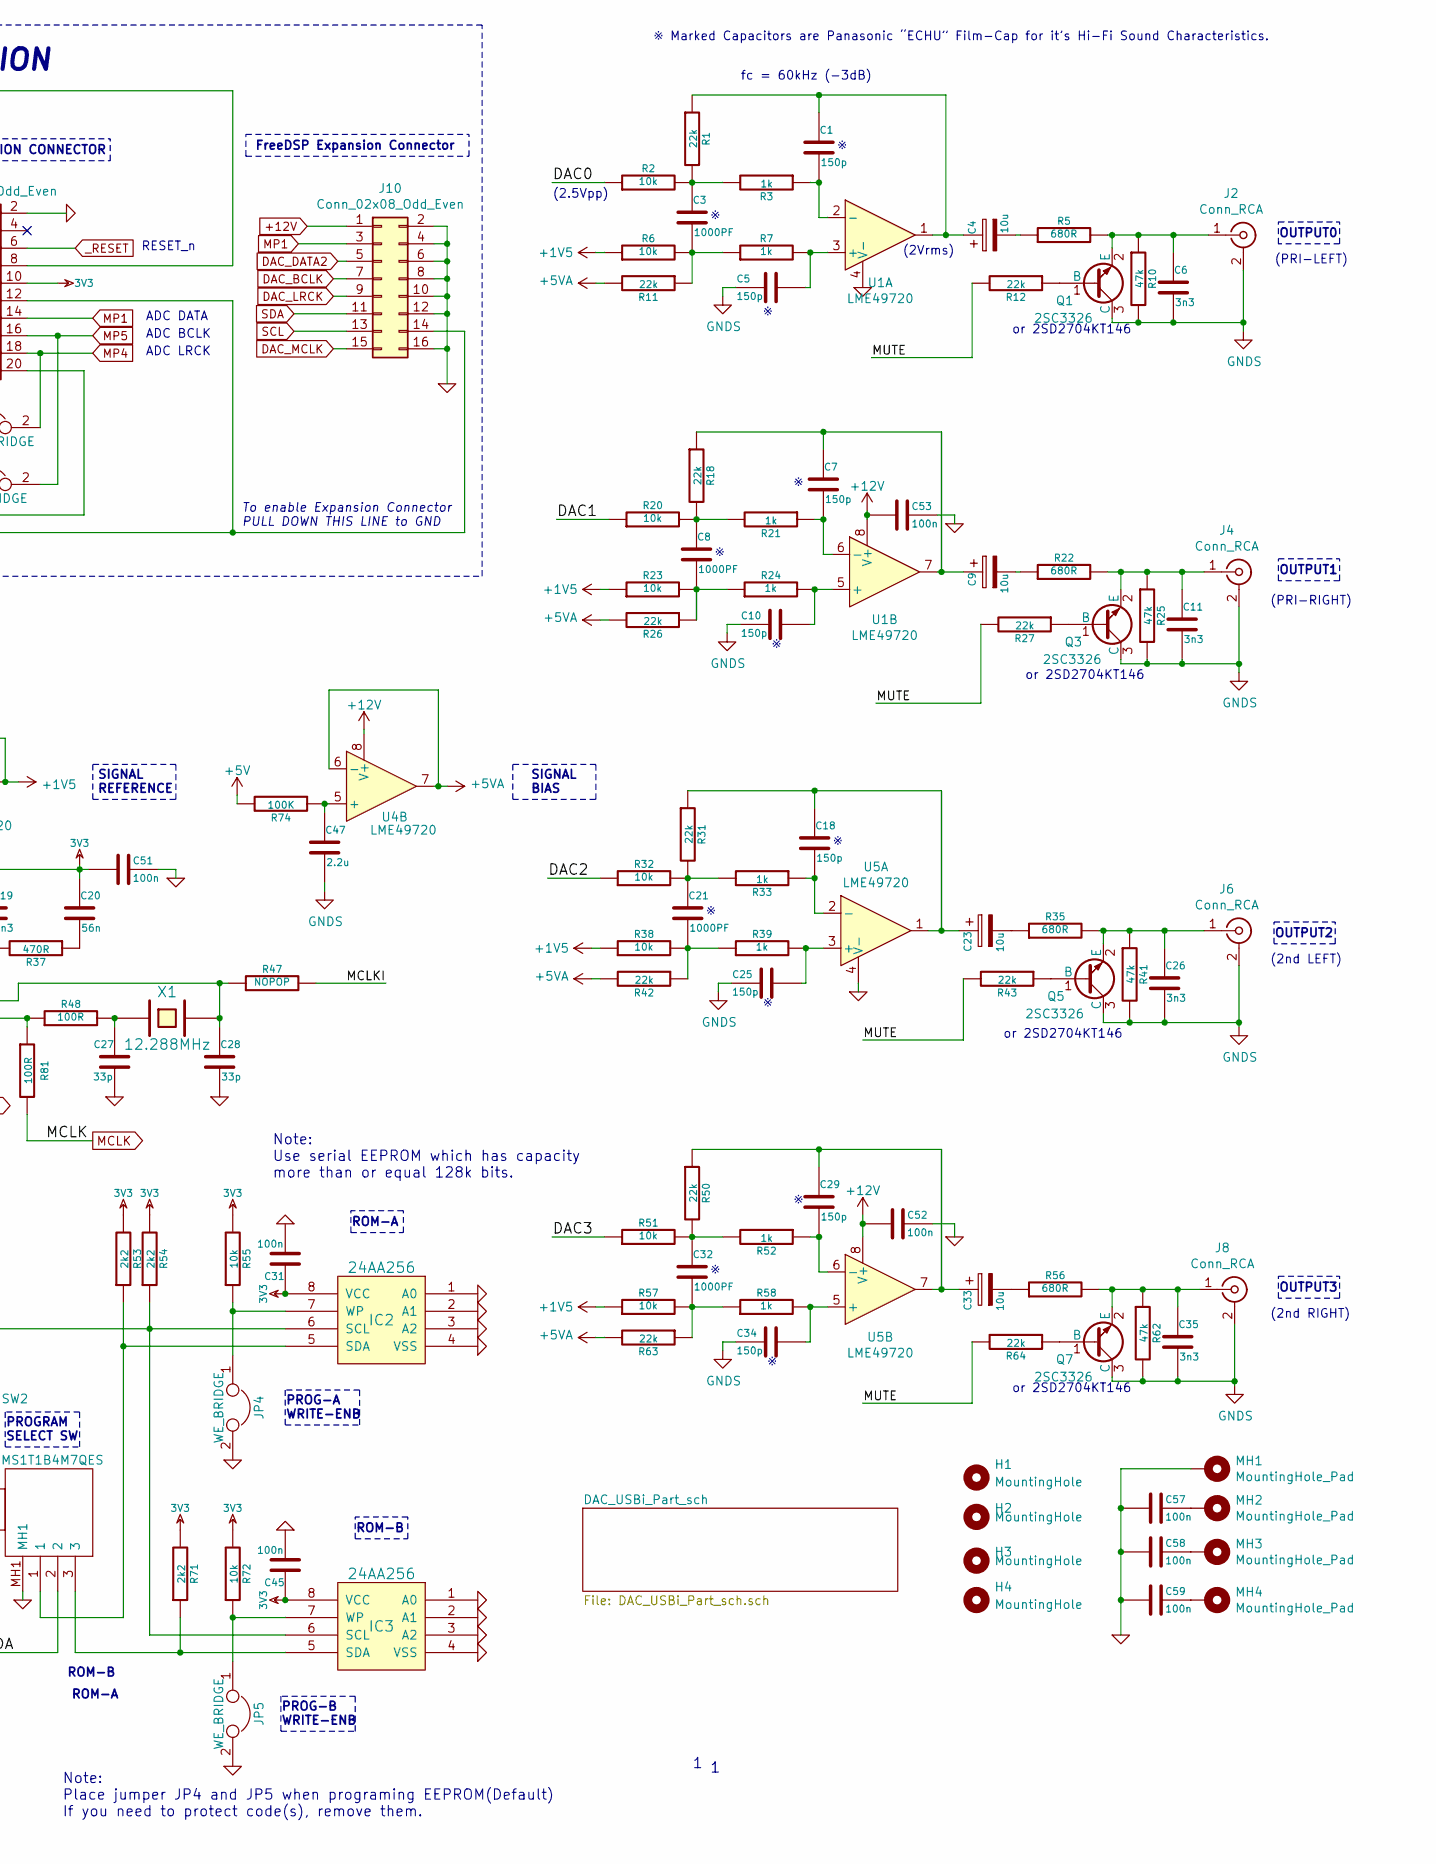
[picture p30: schematic FreeDSP_SMD_AB_plus.sch, FreeDSP Classic SMD A/B plus II (1of2), part in row 1, column 2]

Parts:
C1, C5, C7, C10, C18, C25, C29, C34: 150p; C_0805_HandSoldering
C2, C17, C31, C37, C42, C44, C45, C50, C51, C52, C53, C57, C58, C59, C60: 100n; C_0805_HandSoldering
C3, C8, C21, C32: 1000PF; C_0805_HandSoldering
C4, C9, C23, C33: 10u; CP_Radial_D5.0mm_P2.00mm
C6, C11, C19, C26, C35: 3n3; C_0805_HandSoldering
C12, C15, C16, C36, C40, C43: 10u; C_0805_HandSoldering
C13, C22: 47uF/6.3; CP_Radial_D4.0mm_P2.00mm
C14, C24: 2.2uF/16; CP_Radial_D4.0mm_P2.00mm
C20: 56n; C_0805_HandSoldering
C27, C28: 33p; C_0805_HandSoldering
C30, C41, C47, C49, C54, C55, C56: 2.2u; C_0805_HandSoldering
C38, C39: 220u; CP_Radial_D8.0mm_P5.00mm
C46: 220u/16V; CP_Radial_D10.0mm_P5.00mm
C48: 10uF; C_1206_HandSoldering
D1, D2, D3: 1N4148W; D_SOD-123
D4, D6, D7, D8: RB160M-30; D_SOD-123
D5: LED_RED; LED_0603_HandSoldering
H1, H2, H3, H4: MountingHole; MountingHole_2.7mm_M2.5
IC1: ADAU1701; LQFP-48_7x7mm_Pitch0.5mm
IC2, IC3: 24AA256; SOIC-8_3.9x4.9mm_Pitch1.27mm
J1: Conn_01x02; PinHeader_1x02_P2.54mm_Vertical
J2, J4, J5, J6, J7, J8: Conn_RCA; RJ-2410N
J3: Conn_02x10_Odd_Even; IDC-Header_2x10_P2.54mm_Vertical
J9: Conn_Power_2.1mm; BARREL_JACK
J10: Conn_02x08_Odd_Even; Pin_Header_Straight_2x08_Pitch2.54mm
JP1: LRCLK_BRIDGE; Pin_Header_Straight_1x02_Pitch2.54mm
JP2: BCK_BRIDGE; Pin_Header_Straight_1x02_Pitch2.54mm
JP3: TACT_ANGLE_PUSH; SW_Tactile_SPST_Angled_PTS645Vx83-2LFS
JP4, JP5: WE_BRIDGE; Pin_Header_Straight_1x02_Pitch2.54mm
L1: CMI321609X100KT; Inductor_1212; MPN LQH2MCN100K02L
MH1: MountingHole_Pad; MountingHole_3.2mm_M3_Pad_Via
MH2, MH3, MH4: MountingHole_Pad; MountingHole_3.2mm_M3_Pad
P1: MIL-10P_Angle; IDC-Header_2x05_P2.54mm_Horizontal
Q1, Q3, Q5, Q7: 2SC3326; SOT-23
Q2, Q4, Q13: AO3400A; SOT-23
Q8: KTA1040D-Y-RTF/P; TO-252-2
Q10, Q12: AO3401A; SOT-23
R1, R11, R12, R18, R26, R27, R31, R42, R43, R50, R63, R64: 22k; R_0805_HandSoldering
R2, R4, R6, R19, R20, R23, R30, R32, R38, R51, R55, R57, R61, R72, R83: 10k; R_0805_HandSoldering
R3, R7, R21, R24, R33, R39, R52, R58, R60, R70, R75, R78, R79: 1k; R_0805_HandSoldering
R5, R22, R35, R56, R68: 680R; R_0805_HandSoldering
R8, R9, R13, R14, R15, R16, R17, R48, R81: 100R; R_0805_HandSoldering
R10, R25, R28, R41, R44, R62: 47k; R_0805_HandSoldering
R29, R45, R67: 100k; R_0805_HandSoldering
R34, R76, R80: 0R; R_0805_HandSoldering
R36, R40, R46: 18k; R_0805_HandSoldering
R37: 470R; R_0805_HandSoldering
R47: NOPOP; R_0805_HandSoldering
R49: 4.7k; R_0805_HandSoldering
R53, R54, R71: 2k2; R_0805_HandSoldering
R59: NOP; R_0805_HandSoldering
R65, R66: 220R; R_0805_HandSoldering
R69: 360R; R_0805_HandSoldering
R73, R94: 1MEG; R_0805_HandSoldering
R74, R82: 100K; R_0805_HandSoldering
RV1, RV2: R_POT_ALPS_RK09_B10K; Potentiometer_Alps_RK09L_Double_Vertical
SW1, SW2: 2MS1T1B4M7QES; Manufacturer_Part_Number 2MS1T1B4M7QES
U1, U3, U4, U5: LME49720; SOIC127P600X175-8N
U2: SN74LV541APWR; TSSOP-20_W4.4mm
U6, U7: AZ1117-ADJ; SOT-223-3_TabPin2
X1: 12.288MHz; Crystal_HC49-U_Vertical

Connections:
3V3: C2.1, C19.1, C20.1, C31.1, C39.1, C40.1, C41.1, C42.1, C45.1, C51.2, C60.1, D2.1 (K), D8.2 (A), IC1.6 (SELFBOOT), IC1.18 (IOVDD), IC1.34 (PVDD), IC1.36 (AVDD), IC1.39 (PLL_MODE1), IC1.48 (AVDD), IC2.8 (VCC), IC3.8 (VCC), J3.9, J3.10, Q8.3 (E), Q12.2 (S), R4.2, R19.2, R49.2, R53.2, R54.2, R55.2, R59.2, R60.2, R66.1, R71.2, R72.2, U2.20 (VCC), U7.2 (VO); also elsewhere on the board
+1V5: R6.1, R23.1, R38.1, R57.1, U4.1, U4.2 (-)
+5V: C37.1, C38.1, R65.1, R74.2, R78.2, U6.2 (VO), U7.3 (VI)
+5VA: R11.2, R26.2, R29.2, R42.2, R45.2, R63.2, U4.6 (-), U4.7
+12V: C36.1, C50.2, C52.2, C53.2, D3.1 (K), D4.2 (A), J10.1, L1.1, R67.1, SW1.2, U1.8 (V+), U3.8 (V+), U4.8 (V+), U5.8 (V+), U6.3 (VI)
/DAC0: IC1.46 (VOUT0), R2.1
/DAC1: IC1.45 (VOUT1), R20.1
/DAC2: IC1.44 (VOUT2), R32.1
/DAC3: IC1.43 (VOUT3), R51.1
/RES_MUTE: Q12.3 (D), Q13.1 (G), R94.2
/WB: IC1.20 (ADDR1/CDATA/WB), R61.2
/WP: IC1.21 (CLATCH/WP), R59.1
BRD_~RESET: C30.1, D2.2 (A), IC1.5 (_RESET), JP3.2, P1.6, Q12.1 (G), R49.1; also elsewhere on the board
DAC_BCLK: J3.15, J10.7, JP2.1, R15.2
DAC_DATA2: J3.13, J10.5, R14.2
DAC_LRCK: J3.17, J10.9, JP1.1, R16.2
DAC_MCLK: J3.19, J10.15, R17.2
GND: C2.2, C12.2, C15.2, C16.2, C27.2, C28.2, C30.2, C31.2, C36.2, C37.2, C38.2, C39.2, C40.2, C41.2, C42.2, C43.2, C44.2, C45.2, C46.2, C49.2, C50.1, C51.1, C52.1, C53.1, C56.1, C57.2, C58.2, C59.2, C60.2, D5.1 (K), IC1.1 (AGND), IC1.7 (ADDR0), IC1.12 (DGND), IC1.25 (DGND), IC1.30 (RSVD), IC1.33 (PGND), IC1.37 (AGND), IC1.38 (PLL_MODE0), IC1.42 (AGND), IC2.1 (A0), IC2.2 (A1), IC2.3 (A2), IC2.4 (VSS), IC3.1 (A0), IC3.2 (A1), IC3.3 (A2), IC3.4 (VSS), J1.1, J3.2, J3.11, J9.2 (Ext), J10.2, J10.4, J10.6, J10.8, J10.10, J10.12, J10.16, JP3.1, JP4.2, JP5.2, MH1.1, P1.10, Q4.2 (S), Q13.2 (S), R34.2, R61.1, R67.2, R68.2, R69.2, R76.1, R80.2, R82.2, R94.1, RV1.4, RV2.4, SW1.MH1, SW2.MH1, U1.4 (V-), U2.10 (GND), U2.19 (G2), U3.4 (V-), U4.4 (V-), U5.4 (V-); also elsewhere on the board
GNDS: C5.2, C6.2, C10.2, C11.2, C17.1, C25.2, C26.2, C34.2, C35.2, C47.2, J2.2 (Ext), J4.2 (Ext), J6.2 (Ext), J8.2 (Ext), Q1.3 (C), Q3.3 (C), Q5.3 (C), Q7.3 (C), R10.2, R25.2, R41.2, R62.2, R76.2; also elsewhere on the board
MCLK: R81.2, U2.8 (A6)
MCLKI: R47.2, U2.11 (Y7)
MP0: IC1.11 (MP0), J1.2
MP1: IC1.10 (MP1), J3.14, J10.3
MP2: IC1.29 (MP2), RV1.5
MP3: IC1.28 (MP3), RV2.5
MP4: IC1.8 (MP4), J3.18, JP1.2
MP5: IC1.9 (MP5), J3.16, JP2.2
MP6: IC1.15 (MP6), U2.2 (A0)
MP7: IC1.14 (MP7), U2.4 (A2)
MP8: IC1.27 (MP8), U2.5 (A3)
MP9: IC1.26 (MP9); also elsewhere on the board
MP10: IC1.16 (MP10), R79.1, U2.7 (A5); also elsewhere on the board
MP11: IC1.19 (MP11), U2.6 (A4); also elsewhere on the board
MUTE: D1.2 (A), Q10.3 (D), R12.2, R27.2, R43.2, R64.2, R83.2; also elsewhere on the board
unnamed: C1.1, C4.1, R1.1, U1.1
unnamed: C1.2, R3.1, U1.2 (-)
unnamed: C3.1, R1.2, R2.2, R3.2
unnamed: C3.2, R6.2, R7.1, R11.1
unnamed: C4.2, R5.1
unnamed: C5.1, R7.2, U1.3 (+)
unnamed: C6.1, J2.1 (In), Q1.2 (E), R5.2, R10.1
unnamed: C7.1, C9.1, R18.1, U1.7
unnamed: C7.2, R21.1, U1.6 (-)
unnamed: C8.1, R18.2, R20.2, R21.2
unnamed: C8.2, R23.2, R24.1, R26.1
unnamed: C9.2, R22.1
unnamed: C10.1, R24.2, U1.5 (+)
unnamed: C11.1, J4.1 (In), Q3.2 (E), R22.2, R25.1
unnamed: C12.1, IC1.41 (FILTD)
unnamed: C13.1, U3.6 (-), U3.7
unnamed: C13.2, R36.1
unnamed: C14.1, R29.1, U3.3 (+)
unnamed: C14.2, J5.1 (In), R28.2
unnamed: C15.1, IC1.47 (FILTA)
unnamed: C16.1, IC1.40 (CM), R30.1
unnamed: C17.2, R30.2, U4.3 (+)
unnamed: C18.1, C23.1, R31.1, U5.1
unnamed: C18.2, R33.1, U5.2 (-)
unnamed: C19.2, IC1.35 (PLL_LF), R37.2
unnamed: C20.2, R37.1
unnamed: C21.1, R31.2, R32.2, R33.2
unnamed: C21.2, R38.2, R39.1, R42.1
unnamed: C22.1, U3.1, U3.2 (-)
unnamed: C22.2, R46.1
unnamed: C23.2, R35.1
unnamed: C24.1, R45.1, U3.5 (+)
unnamed: C24.2, J7.1 (In), R44.2
unnamed: C25.1, R39.2, U5.3 (+)
unnamed: C26.1, J6.1 (In), Q5.2 (E), R35.2, R41.1
unnamed: C27.1, R48.2, X1.1
unnamed: C28.1, IC1.32 (MCLKI), R47.1, X1.2
unnamed: C29.1, C33.1, R50.1, U5.7
unnamed: C29.2, R52.1, U5.6 (-)
unnamed: C32.1, R50.2, R51.2, R52.2
unnamed: C32.2, R57.2, R58.1, R63.1
unnamed: C33.2, R56.1
unnamed: C34.1, R58.2, U5.5 (+)
unnamed: C35.1, J8.1 (In), Q7.2 (E), R56.2, R62.1
unnamed: C43.1, C44.1, IC1.13 (DVDD), IC1.24 (DVDD), Q8.2 (C)
unnamed: C46.1, D4.1 (K), Q10.2 (S), R73.1
unnamed: C47.1, R74.1, U4.5 (+)
unnamed: C48.1, L1.2, R70.2
unnamed: C48.2, C55.2, D7.1 (K), Q2.2 (S), R80.1
unnamed: C49.1, D3.2 (A), Q10.1 (G), Q13.3 (D), R73.2
unnamed: C54.1, Q2.3 (D), R70.1
unnamed: C54.2, D6.1 (K), D7.2 (A)
unnamed: C55.1, D6.2 (A), R75.1
unnamed: C56.2, R75.2, R83.1
unnamed: C57.1, MH2.1
unnamed: C58.1, MH3.1
unnamed: C59.1, MH4.1
unnamed: D1.1 (K), Q4.1 (G), R82.1
unnamed: D5.2 (A), R78.1
unnamed: D8.1 (K), RV1.6, RV2.6
unnamed: IC1.2 (ADC0), R36.2
unnamed: IC1.3 (ADC_RES), R40.2
unnamed: IC1.4 (ADC1), R46.2
unnamed: IC1.17 (VDRIVE), Q8.1 (B), R60.1
unnamed: IC1.31 (OSCO), R48.1, R81.1
unnamed: IC2.5 (SDA), R53.1, SW2.1
unnamed: IC2.7 (WP), JP4.1, R55.1
unnamed: IC3.5 (SDA), R71.1, SW2.3
unnamed: IC3.7 (WP), JP5.1, R72.1
unnamed: J3.5, R8.2
unnamed: J3.7, R9.2
unnamed: J3.8, R13.2
unnamed: J3.20, U2.9 (A7)
unnamed: J5.2 (Ext), J7.2 (Ext), R28.1, R34.1, R40.1, R44.1
unnamed: J9.1 (In), SW1.1
unnamed: J3.12, J10.14, R19.1, U2.1 (G1)
unnamed: Q1.1 (B), R12.1
unnamed: Q2.1 (G), R79.2
unnamed: Q3.1 (B), R27.1
unnamed: Q4.3 (D), R4.1, U2.3 (A1)
unnamed: Q5.1 (B), R43.1
unnamed: Q7.1 (B), R64.1
unnamed: R8.1, U2.18 (Y0)
unnamed: R9.1, U2.17 (Y1)
unnamed: R13.1, U2.16 (Y2)
unnamed: R14.1, U2.15 (Y3)
unnamed: R15.1, U2.14 (Y4)
unnamed: R16.1, U2.13 (Y5)
unnamed: R17.1, U2.12 (Y6)
unnamed: R65.2, R68.1, U6.1 (ADJ)
unnamed: R66.2, R69.1, U7.1 (ADJ)
SCL: IC1.23 (SCL/CCLK), IC2.6 (SCL), IC3.6 (SCL), J3.3, J10.13, P1.1, R54.1; also elsewhere on the board
SDA: IC1.22 (SDA/COUT), J3.1, J10.11, P1.3, SW2.2; also elsewhere on the board

Notes on the sheet:
<=1%
RESET SW
DAC DATA0
DAC MUTE_n
I2C SCL
I2C SDA
RESET_n
DAC DATA1
EXT-MCLK IN
ADC LRCK
ADC BCLK
ADC DATA
I2S I/O EXPANSION CONNECTOR
POT-1
POT-2
ROM-A
ROM-B
USBi
DC12V
fc = 60kHz (-3dB)
(2.5Vpp)
(2Vrms)
MUTING
INPUT 0
INPUT 1
OUTPUT0
OUTPUT1
OUTPUT2
OUTPUT3
PROGRAM SELECT SW
SIGNAL REFERENCE
SIGNAL BIAS
_EXT-ENABLE
PROG-A WRITE-ENB
PROG-B WRITE-ENB
GPIO
MP9 GND
OPTIONAL PART FOR I/O EXTENSION
FreeDSP Expansion Connector
Note: Use serial EEPROM which has capacity more than or equal 128k bits.
(AUX-ADC1)
(AUX-ADC2)
or 2SD2704KT146
RESERVE MUTE POWER CAP
Use Si Switching Diode for D2 and D3 Shotkey is NOT suitable
※ Marked Capacitors are Panasonic “ECHU” Film-Cap for it’s Hi-Fi Sound Characteristics.
POWER INDICATOR
CHARGE PUMP
(48kHz)
-11V
+1.5V
3.0V
Maximum AUX-ADC Input Voltage is 3.0V
Use Shotkey Diode for D4,D6 and D7.
Note: Place jumper JP4 and JP5 when programing EEPROM(Default) If you need to protect code(s), remove them.
(Shotkey)
Use Si Switching Diode for D1 Shotkey is NOT suitable
(RIGHT)
(LEFT)
(PRI-RIGHT)
(PRI-LEFT)
(2nd RIGHT)
(2nd LEFT)
(10uH, >10mA)
(2SB1203)
PARAMETER CONTROLS
To enable Expansion Connector PULL DOWN THIS LINE to GND
R49 should tie to 3V3 a little bit strongly 4.7k is enough.

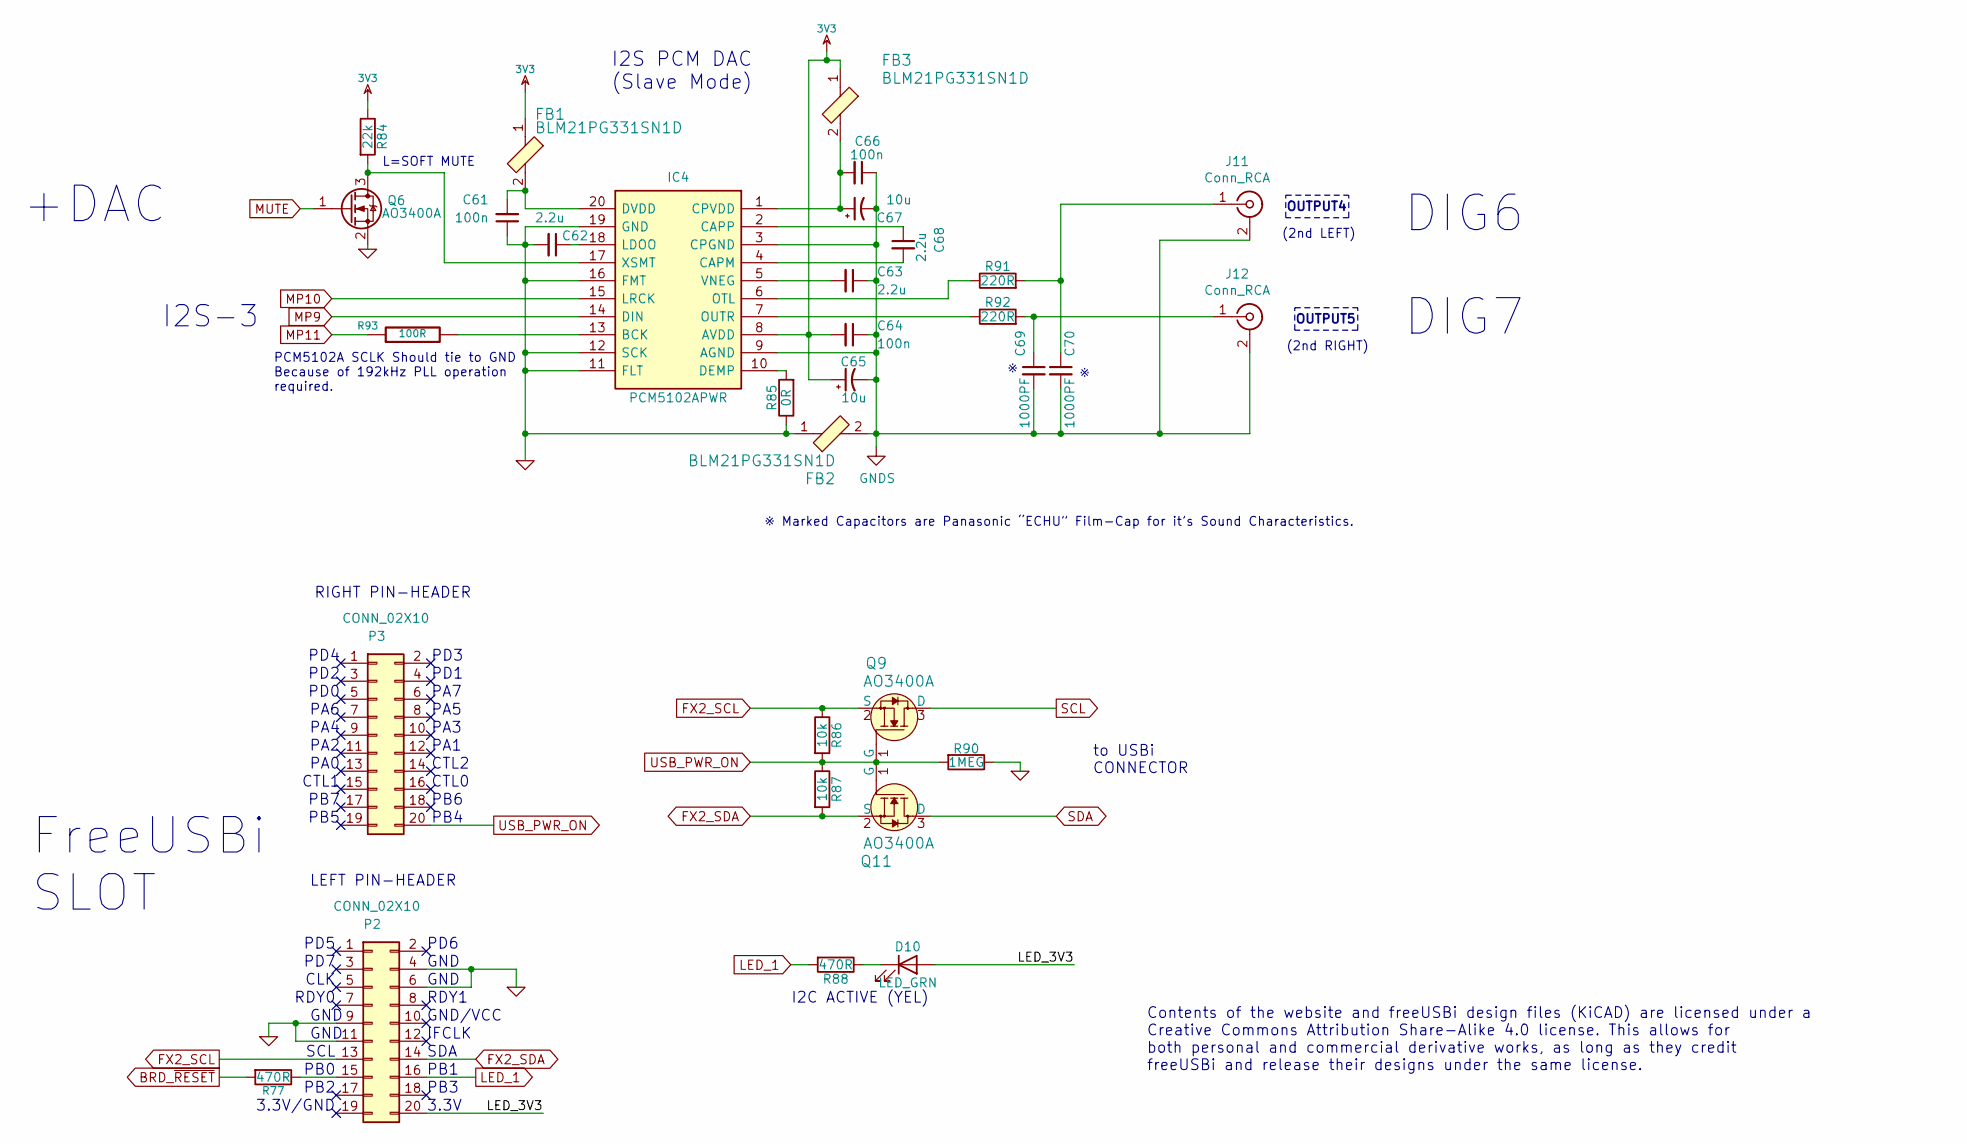
[picture p31: schematic DAC_USBi_Part_sch.sch, FreeDSP Classic SMD A/B plus II (2of2)]

Parts:
C61, C64, C66: 100n; C_0805_HandSoldering
C62, C63, C68: 2.2u; C_0805_HandSoldering
C65, C67: 10u; C_0805_HandSoldering
C69, C70: 1000PF; C_0805_HandSoldering
D10: LED_GRN; LED_0603_HandSoldering
FB1, FB2, FB3: BLM21PG331SN1D; 0805; MPN BLM21PG331SN1D; Digi-Key_PN 490-5988-1-ND
IC4: PCM5102APWR; TSSOP-20_4.4x6.5mm_P0.65mm; Manufacturer_Part_Number PCM5102APWR
J11, J12: Conn_RCA; RJ-2410N
P2, P3: CONN_02X10; PinSocket_2x10_P2.54mm_Vertical
Q6: AO3400A; SOT-23
Q9, Q11: AO3400A; SOT-23-3; MPN 2N7002; Digi-Key_PN 2N7002NCT-ND
R77, R88: 470R; R_0805_HandSoldering
R84: 22k; R_0805_HandSoldering
R85: 0R; R_0805_HandSoldering
R86, R87: 10k; R_0805_HandSoldering
R90: 1MEG; R_0805_HandSoldering
R91, R92: 220R; R_0805_HandSoldering
R93: 100R; R_0805_HandSoldering

Connections:
3V3: C64.2, C65.1, FB1.1, FB3.1, IC4.8 (AVDD), R84.1; also elsewhere on the board
/DAC_USBi_Part_sch/LED_3V3: D10.2 (A), P2.20
BRD_~RESET: R77.2; also elsewhere on the board
FX2_SCL: P2.13, Q9.2 (S), R86.1
FX2_SDA: P2.14, Q11.2 (S), R87.2
GND: C61.1, C62.2, FB2.1, IC4.11 (FLT), IC4.12 (SCK), IC4.16 (FMT), IC4.19 (GND), P2.4, P2.6, P2.9, P2.11, Q6.2 (S), R85.1, R90.1; also elsewhere on the board
GNDS: C63.1, C64.1, C65.2, C66.1, C67.2, C69.2, C70.2, FB2.2, IC4.3 (CPGND), IC4.9 (AGND), J11.2 (Ext), J12.2 (Ext); also elsewhere on the board
LED_1: P2.16, R88.2
MP9: IC4.14 (DIN); also elsewhere on the board
MP10: IC4.15 (LRCK); also elsewhere on the board
MP11: R93.1; also elsewhere on the board
MUTE: Q6.1 (G); also elsewhere on the board
unnamed: C61.2, FB1.2, IC4.20 (DVDD)
unnamed: C62.1, IC4.18 (LDOO)
unnamed: C63.2, IC4.5 (VNEG)
unnamed: C66.2, C67.1, FB3.2, IC4.1 (CPVDD)
unnamed: C68.1, IC4.2 (CAPP)
unnamed: C68.2, IC4.4 (CAPM)
unnamed: C69.1, J12.1 (In), R92.2
unnamed: C70.1, J11.1 (In), R91.2
unnamed: D10.1 (K), R88.1
unnamed: IC4.6 (OTL), R91.1
unnamed: IC4.7 (OUTR), R92.1
unnamed: IC4.10 (DEMP), R85.2
unnamed: IC4.13 (BCK), R93.2
unnamed: IC4.17 (XSMT), Q6.3 (D), R84.2
unnamed: P2.15, R77.1
SCL: Q9.3 (D); also elsewhere on the board
SDA: Q11.3 (D); also elsewhere on the board
USB_PWR_ON: P3.20, Q9.1 (G), Q11.1 (G), R86.2, R87.1, R90.2

Notes on the sheet:
I2S PCM DAC (Slave Mode)
I2S-3
DIG6
L=SOFT MUTE
PD6
RDY1
IFCLK
SDA
PB1
PB3
PB0
PB2
SCL
RDY0
CLK
PD7
PD5
GND
GND/VCC
PD3
PD1
PA7
PA5
PA3
PA1
PA2
PA4
PA6
PA0
PD0
PD2
PD4
CTL1
CTL0
CTL2
PB6
PB4
PB7
PB5
3.3V/GND
3.3V
I2C ACTIVE (YEL)
to USBi CONNECTOR
Contents of the website and freeUSBi design files (KiCAD) are licensed under a Creative Commons Attribution Share-Alike 4.0 license. This allows for both personal and commercial derivative works, as long as they credit freeUSBi and release their designs under the same license.
LEFT PIN-HEADER
RIGHT PIN-HEADER
OUTPUT4
OUTPUT5
(2nd RIGHT)
(2nd LEFT)
DIG7
※ Marked Capacitors are Panasonic “ECHU” Film-Cap for it’s Sound Characteristics.
FreeUSBi SLOT
+DAC
PCM5102A SCLK Should tie to GND Because of 192kHz PLL operation required.

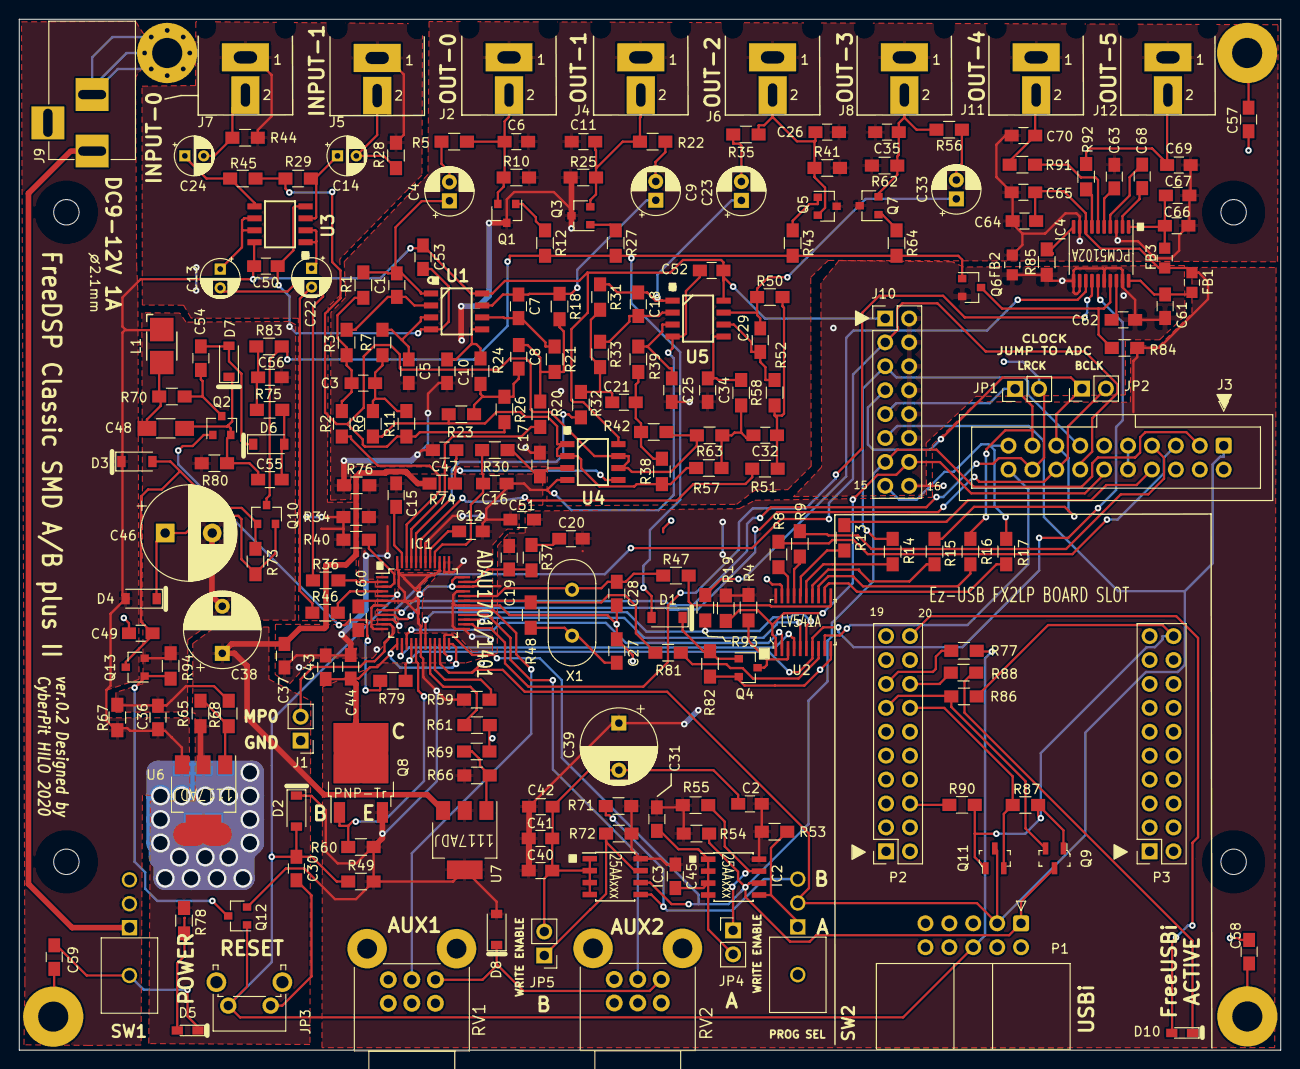
[picture p32: board FreeDSP_SMD_AB_plus.kicad_pcb from above]

Board: 2 copper layers, 134.0 x 109.5 mm, 233 parts (0 on the bottom side), 147 nets.
