CyberPit/FreeDSP_Classic_SMD_AB_plus-II/(commit log)

2020-10-11 FreeDSP Classic SMD A/B plus II ver.2 Ki-CAD Files
    [DAC_USBi_Part_sch.sch, FreeDSP_SMD_AB_plus.dsn, FreeDSP_SMD_AB_plus.kicad_pcb, FreeDSP_SMD_AB_plus.sch]
2020-10-11 Version 0.2 Board Gerber Files
    [FreeDSP_SMD_AB_plus-B_Cu.gbl, FreeDSP_SMD_AB_plus-B_Mask.gbs, FreeDSP_SMD_AB_plus-B_Paste.gbp, FreeDSP_SMD_AB_plus-B_SilkS.gbo, FreeDSP_SMD_AB_plus-Edge_Cuts.gm1, FreeDSP_SMD_AB_plus-F_Cu.gtl, FreeDSP_SMD_AB_plus-F_Mask.gts, FreeDSP_SMD_AB_plus-F_Paste.gtp]
2020-10-11 Actual Photsos are ver.1 Board.
2020-10-11 PCBA Oder Package for JLPCB (https://jlcpcb.com/)
    [FreeDSP_SMD_AB_plus_BOM1.xlsx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]
2020-10-16 R49 was changed to 4K7
    [FreeDSP_SMD_AB_plus_BOM1.xlsx]
2021-02-23 Board Casing Images
2021-03-13 Sample Application 3way Crossover fs=96kHz
2021-12-11 Fixed format error and CPL infomation
    FB1, FB2, FB3, U2 are SMD parts.
    [FreeDSP_SMD_AB_plus_0v2_BOM1.xlsx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]
2023-07-13 Fixed PCBA Package for JLPCB (https://jlcpcb.com/)
    [FreeDSP_SMD_AB_plus_0v2_BOM1.xlsx]
